myt-bot/footguard/docs/GAIT_CAPTURE_2026-08-15.md

# 2026-08-15 基础步态采集记录

本记录用于工程验证，不是医学步态诊断或糖尿病足临床结论。

## 时间与动作分段

- 手机记录约为 01:50～02:00，电脑比手机早约 2～3 分钟；数据库中有效承重数据集中在电脑时间 01:50:00～01:55:05。
- 01:50:00～01:50:55：初始静止与穿戴基线。
- 01:51:00～01:52:20：自然行走，包含三个来回及转身。
- 01:52:25～01:52:55：中间静止。
- 01:53:00～01:54:05：慢速行走，包含两个来回及转身。
- 01:54:10～01:55:05：结束静止。
- 01:55:05 之后压力基本归零，按卸载鞋垫处理，不纳入步态段。

## 初步结果

- 保存的站立基线 `load_ratio=0.0484`、`load_ratio_mad=0.0331` 可用于校正左右手工鞋垫灵敏度差，不能把行走样本混入站立基线。
- 新增基础步态观察使用近 12 秒窗口、左右交替承重和 MPU 运动状态。
- 本次数据回放中，静止段输出“静止”；自然行走窗口约 8 个落脚候选、估算 69 步/分钟；慢走窗口约 7 个候选、估算约 44～60 步/分钟。
- 转身或短暂停顿会使单个窗口暂时回到“静止”或“数据不足”，因此当前不把来回次数等同于连续直线步频。

## 数据质量限制

- 有效区间约 4455 对左右帧。
- 单侧帧间隔中位数约 50～60 ms，但按包序号估算约缺失 1660 个序号，丢帧比例约 27%。左右侧缺失序号基本同步，更像 App 配对或上传队列丢失，而不是单块鞋垫独立断流。
- 这批数据足以验证静止/行走、左右交替和时间戳步频算法，但不适合宣称最终 20 Hz 链路验收或步态准确率。

## 下一轮复测

1. 先修复或定位同步丢帧，使持续采集的序号缺失率降到 2% 以下。
2. 保持同一穿戴方式，分别采集直线自然走和直线慢走，转身段单独标记。
3. 每段同步记录人工步数，用于计算落脚候选的漏检和误检。
4. 至少重复三次穿戴，确认站立基线校正后步频仍稳定。

## 第二轮现场问题与修复

- 02:40～02:50 的第二轮测试中，数据库每侧仅收到约 1960 帧，并出现约 40 秒空洞。后端已在 02:42:17 将左偏载事件标记为恢复，但 App 因上传失败切到滞后的本地配对结果，仍显示未恢复。
- 原 App 配对器只保留左右各一帧；一侧先到下一包会覆盖尚未配对的上一包。现改为按 `sync_id + packet_seq` 缓冲 128 组，允许左右通知乱序到达。
- 上传改为 100 ms 微批次，本地队列每 500 ms 去抖保存；启动时历史补传数量单独计数，瞬时失败不再把后续实时帧送入只归档的补传接口。
- 后端为空载温度基线保留更长校准窗口，并可将已有的全 `unstable` 温度配置从本次原始空载段自动修复。第二轮配置已恢复为 3 个 `normal_offset` 和 1 个 `assembly_offset`，温度风险重新启用。
- 为 `sensor_frames(side, timestamp_ms)` 增加组合索引，当前数据库的 `/api/v1/realtime` 从约 1.2～1.4 秒降到约 60～80 ms。
