myt-bot/footguard/protocol/REVISION_NOTES_v1_2.md

# FootGuard protocol v1.2 修订说明

本修订发生在真实硬件联调前，以新的双足传感器示意图取代 `layout_6p3t_v1`。

## 破坏性变化

- 唯一支持的布局改为 `layout_6p4t_v1`：每脚 6 个压力通道和 4 个温度通道。
- BLE `layout_id` 从 1 改为 2。
- SensorData 从 58 字节改为 60 字节，温度字段从 `3×int16` 改为 `4×int16`。
- IMU、电量和 CRC 字段向后移动 2 字节；CRC 覆盖偏移 0～57，存放于 58～59。
- T4 占用 quality_flags 第 9 位，后续状态位整体后移一位。
- 旧 CSV、SQLite 数据库和旧 BLE 测试向量不得与新布局混用。

## 新通道映射

- P1 拇趾区；P2 前掌外侧；P3 前掌中央；P4 前掌内侧；P5 中足中央；P6 足跟中央。
- T1 前掌外侧；T2 拇趾/第一跖骨头邻近的前掌内侧；T3 足跟中央；T4 中足中央。
- 左右脚按解剖方向镜像，通道含义保持一致。

## 风险算法变化

- 不用原始压力固定阈值直接判定。
- 双足偏载使用归一化载荷差，区域风险使用足内占比、左右同区对比和个人动态基线。
- 温度使用左右镜像同区温差，并扣除个人正常温差基线。

固件、Flutter、后端、测试向量和模拟数据必须在同一次合并中同步升级。

竞赛演示中的后端马达命令有效期为 30 秒；设备重连产生新的连续监测窗口时，同类型旧事件不会阻止新命令生成。
