myt-bot/footguard/docs/DEMO_GUIDE.md

# FootGuard 初赛演示口径与操作清单

## 一句话介绍

“足安智垫”是一套面向糖尿病足日常管理场景的双足风险辅助监测原型。它不只显示压力和温度，还能比较个人基线和左右差异，识别持续风险，调用 DeepSeek 给出非诊断性解释，向风险侧震动提醒，并用后续数据验证提醒是否带来改善。

## 演示前 15 分钟

1. 电脑和手机连接同一局域网，电脑启动 FastAPI，DeepSeek 密钥已在环境变量中。
2. 两块 ESP32 分别供电，确认广播为 `FootGuard-L` 和 `FootGuard-R`。
3. App 选择“BLE 真机实时数据”，后端地址填写电脑局域网 IP。
4. 确认左右设备已连接、后台在线、双足同步误差稳定。
5. 实时页点击“新体验者 / 重新穿戴”，体验者双脚自然平行站立约 8～12 秒，确认进度达到 40/40 且显示“本次穿戴已就绪”。
6. 先测试一次目标侧震动和 ACK，再清理过期测试命令。
7. 准备 CSV/Mock 回放作为断网或实物故障备用，但不要把模拟画面说成真实采集。

## 建议视频流程（约 3～4 分钟）

### 1. 作品与架构（25 秒）

镜头展示双足实物、每脚 6 个压力点和 4 个温度点、两块 ESP32 与手机 App。

口径：

> 两只脚独立采集，通过 BLE 同步到同一个 App。电脑当前只在后台运行 FastAPI 和大模型调用，可以不出镜。风险识别由可解释规则和个人基线完成，大模型不直接控制马达。

### 2. 双足连接和个人基线（30 秒）

展示设备页的左右连接，在实时页开始本次穿戴标定并直接观察进度和失败原因。

口径：

> 不同人的体重、站姿、左右受力和鞋垫灵敏度都不同，所以每次重新穿戴都学习约 8 到 12 秒的稳定站立基线。校准完成前压力图照常显示，但压力风险和压力马达暂停，避免把鞋垫固有不对称当作风险。

### 3. 正常状态（20 秒）

自然站立，展示热力分布、左右温差和“双足状态正常”。

口径：

> 压力基础颜色显示当前低到高受力，无风险时也不会空白；风险用单独描边表达。温度采用左右同区比较，任一温度点缺失都不会影响压力图或压力风险。

### 4. 行走趋势（约 2 分钟）

先完成三段相互独立的短直线自然行走，确认均处于正常范围；再完成一段有意保持单侧偏载或前掌受压的行走。每段至少 6 次有效落脚、左右各至少 3 次，转弯后停稳约 2 秒再开始下一段。正式演示只选择“持续单侧偏载”或“前掌反复受压”之一，不演示内外侧或步时波动诊断。

口径：

> 单个有效行走段达到现有工程阈值即可触发一次语音提醒，足够用于现场演示；连续三段同向、同类型且累计至少 18 次落脚时，系统另外记录为重复趋势。低步频不单独判异常。

### 5. 持续偏载/前掌高载（45 秒）

缓慢把重心偏向预定一侧或保持前掌持续受力，不要突然猛踩。先保持到等级 2，确认准确风险名称播报。

口径：

> 瞬时高压不会立刻报警；只有持续达到条件才升级。等级 2 播报具体风险名称，但不会震动。

展示准确风险名称、全部组成项和已执行干预结果。站立可按左偏、右偏、左脚前倾、右脚前倾、双脚前倾、左脚内侧受压、右脚外侧受压的顺序演示；该顺序只是现场脚本，不是检测优先级。

### 6. 未改善升级（可选，25 秒）

继续保持风险至等级 3，展示对应风险侧的单次长震。

口径：

> 风险持续到最高等级后，系统只向对应脚发送一次长震；相同事件不会因 App 轮询而重复执行。

### 7. 干预前后效果（35 秒）

恢复自然站立，等待风险解除，打开历史页并展开最新事件。

口径：

> 系统比较干预前约 3 秒与 15 秒观察窗末端约 5 秒的有效静止数据。左右负载、前掌、内侧和外侧均按个人基线异常量显示改善或加重；数据不足时不下结论，温度不计入这项短时压力改善率。

### 8. 温度差异（可选，25 秒）

用手掌捂住单侧一个 NTC，缓慢升温；不要使用热风枪、明火、沸水或直接贴高温暖宝宝。

口径：

> 糖尿病足场景中温度差异值得关注，但本原型只做趋势辅助提醒，不作诊断。我们比较左右对应区域并扣除个人正常差异。

### 9. 总结（15 秒）

> 我们完成了双足真实感知、同步融合、个人基线、站立与行走负荷评估、云端大模型辅助解释、目标侧震动和干预后效果评价的完整 AIoT 闭环。后续工作是扩大参与者与行走数据，用于验证步态问题阈值和临床相关性。

## 评委常问问题

**为什么不用几十点压力鞋垫？**

本项目不以点数取胜，而以低成本关键区域采样、双足同步、个人基线、压力温度融合、闭环干预和效果评价形成差异化。六点压力不是连续医疗压力图，页面也明确按相对分布呈现。

**大模型有什么必要？**

确定性引擎负责风险和安全动作；大模型把结构化结果转成用户能理解的解释与建议。超时或格式错误会降级到模板，因此不会影响提醒闭环。

**换一个人还准吗？**

不能直接沿用上一人的基线。换人或重新穿鞋后都要快速标定，系统按其本次穿戴的载荷比、区域分布和噪声工作。当前只完成单人重复穿戴工程验证，现场可支持新体验者快速适配，但不宣称已验证多人准确率。

**为什么不显示电量？**

当前使用充电宝，协议中的百分比还不是可靠电量计读数，因此 App 主动隐藏。后续改为锂电池并接入真实电量计后再恢复电量和低电告警。

**为什么需要电脑？**

当前竞赛原型由电脑在局域网中运行 FastAPI 和 DeepSeek 调用，电脑可以不出镜。产品化时可迁移到公网云服务器，不改变鞋垫和 App 架构。

**MPU 现在有什么作用？**

固件和协议已采集加速度与角速度并带质量标记；完整的站立/行走/冲击约束需要更多可靠行走数据验证。演示不应把尚未验证的步态分类说成已完成医学能力。

## 失败时的降级顺序

1. DeepSeek 不可用：展示本地模板，强调核心判断不依赖大模型。
2. 后端网络异常：BLE 本地压力图继续显示，但风险闭环和马达暂停并明确提示；需要完整流程时切换准备好的 Mock/CSV，并清楚说明是演示数据。
3. 单脚断连：展示数据质量和暂停双足判断，不声称正常。
4. 马达未执行：展示命令过期/失败状态和 ACK 日志，不手动伪造成功。
5. 传感器接触不良：停止该场景，先检查空载与逐点响应，不临时放宽到明显误报。

## 最终复测记录

- 体验者编号与鞋码（匿名）
- 传感器固定版本和时间
- 五次独立穿戴，每次 40 对帧标定是否在约 12 秒内完成
- 每次自然站立 60 秒是否无等级 2/3 压力误报
- 左偏、恢复、右偏、恢复各 3 次，记录触发侧、触发时间和恢复时间
- 前掌受力和恢复各 3 次，记录触发与漏报情况
- 任一温度点、多个温度点或全部温度无效时，压力图和压力风险是否继续
- 等级 2 准确风险名称播报、等级 3 对应脚单次长震、ACK 是否正确
- 历史页干预前后值和恢复时间
- 所有调整过的阈值、理由与复测结果

今天固定前的数据仍可作为阶段性工程证据，用来说明通道响应、主要风险方向和闭环功能已经出现；由于传感器位置、接触和手工左右结构存在不确定性，不把它宣传为最终标定或准确率结论。胶固化后的短复测用于确认重复性并完成最终演示取材。
