myt-bot/footguard/docs/DEFENSE_QA_100.md

# FootGuard 足安智垫答辩材料

## 一、先把项目定位说准确

### 一句话定位

FootGuard 是面向**糖尿病足风险人群日常观察**的双足多源风险辅助监测原型。它把双脚相对压力、局部温度和运动状态放在同一条时间线上，发现持续或重复的受力/温度变化后，给出提醒、记录提醒后的变化，并用大模型把结果翻译成普通人听得懂的分析和建议。

### 它服务谁

主要服务对象是已经确诊糖尿病、但当前未必已经发生溃疡或感染、需要长期关注足部受力和温度变化的人，尤其是有周围神经病变、既往溃疡/截肢史、足部感觉减退、下肢供血问题、足部畸形或反复局部受压风险的人。

### 它不是什么

它不是医院诊断设备，不判断“有没有糖尿病足”，不计算 IWGDF 0–3 级，不预测某个人一定会溃疡，也不治疗感染、溃疡或缺血。对已经有破溃、感染、明显发热、发黑、剧痛或突然肿胀的人，设备只能作为记录工具，不能替代立即的专业足部检查。

### 为什么仍然和糖尿病足强相关

糖尿病足管理的重要方向包括减轻异常机械负荷、观察足部皮温不对称、及时发现重复的局部风险并进行专业复核。FootGuard 把这些方向变成低成本、可重复、可解释的工程观察：压力回答“哪里受力反复偏高”，温度回答“同一解剖区域是否出现持续温差”，行走分析回答“走动时是否重复偏向一侧或前掌”，提醒后记录回答“短时间内是否出现受力变化”。这些证据可以帮助用户更早注意问题，但不能替代临床检查。

### 主要依据

- IWGDF 2023 Prevention Guideline：家庭足温监测中，同一对应部位温差约 2.2°C、连续两天出现时，应减少活动并联系专业人员；项目把它作为设计参考，不把几十秒演示伪装成两天临床证据。
- IWGDF 2023 Offloading Guideline：糖尿病足高风险管理强调减负和避免异常机械应力；项目的压力区域、偏载和提醒后变化围绕“辅助发现需要减负/复核的受力模式”设计。
- ADA Standards of Care 2026 足部护理：既往溃疡/截肢、感觉减退和下肢供血问题是重要背景资料；项目只允许录入这两个最小背景提示，不冒充完整临床分层。
- 糖尿病神经病变与步态研究：步态指标存在较大异质性；项目保留行走步数、步频和受力指标作工程观察，不把单次步频或步时波动包装成诊断。

## 二、系统怎么工作

`FSR/NTC/MPU6050 -> ESP32-S3 -> BLE GATT -> Flutter App -> FastAPI/SQLite -> 规则引擎 -> AI解释/语音/马达 -> ACK -> 15秒观察 -> 历史趋势`

1. 每只鞋垫独立采集 6 路 FSR、4 路 NTC 和 1 个 MPU6050。
2. ESP32-S3 把一条完整传感器帧通过 BLE Notify 发给 App。
3. App 校验侧别、协议版本、布局、长度、CRC、时间同步和质量位，再把左右脚按 `sync_id + packet_seq` 配对。
4. App 将统一 JSON 上传给 FastAPI；后端不直接解析 BLE 字节。
5. 后端先判断帧能否用于压力/温度/步态，再用本次穿戴基线计算相对变化。
6. 确定性规则负责风险等级、语音和震动，AI 只负责解释，不拥有马达控制权。
7. ESP32 执行命令后回传 ACK；后端以真实 ACK 和观察窗口计算提醒后的变化。
8. 数据写入 SQLite，历史页显示事件、趋势、温度真实记录/演示记录、健康背景和血糖背景。

## 三、底层参数速查

| 项目 | 当前实现 |
|---|---|
| MCU | ESP32-S3 |
| FSR | 每脚 6 路，ADC1，P1-P6 映射 GPIO1-GPIO6，12 dB 衰减，每通道 32 次 ADC 采样平均 |
| NTC | 每脚 4 路，GPIO7-GPIO10/ADC1_CH6-CH9，10K B3950，固定 10K，3.3 V，32 次采样平均，ADC 曲线校准 |
| IMU | MPU6050，I2C0，SDA GPIO11，SCL GPIO12，7-bit 地址 0x68，100 kHz |
| MPU 配置 | SMPLRT_DIV=9，内部约 100 Hz；DLPF_CFG=3；陀螺 ±250°/s；加速度 ±2 g；App 帧读取频率为 20 Hz |
| 传感器帧 | 20 Hz，50 ms 一帧；压力和 MPU 每帧更新，温度每 4 帧刷新一次，即约 5 Hz，其余帧复用最近温度 |
| BLE 帧 | 固定 60 字节，little-endian，CRC-16/CCITT-FALSE 覆盖前 58 字节 |
| BLE MTU | App 请求 247；SensorData 至少需要 MTU 63；JSON 单包上限为 `MTU-3`，不分包 |
| TimeSync | 12 字节：uint32 `sync_id` + uint64 Unix 毫秒时间 |
| 双脚配对 | 相同 `sync_id`、相同 `packet_seq`、左右时间差不超过 50 ms |
| 标定 | 至少 40 对稳定完整压力帧，通常 8–12 秒；基线持久化到 SQLite |
| 压力平滑 | 5 个 5 Hz 压力样本，约 1 秒滚动中位数 |
| 行走观察 | 最近 12 秒；至少 4 秒、6 次交替落脚、左右各至少 3 次 |
| 压力风险持续 | 约 5 秒关注、10 秒需复核、20 秒持续异常 |
| 温度工程窗口 | 约 8 秒观察、15 秒语音、30 秒持续；不是“两天临床证据” |
| 震动 | 只有等级 3；目标侧单次 long，1500 ms；命令有过期时间和去重 |
| 恢复观察 | 干预前约 3 秒、干预后 15 秒窗口末端约 5 秒；每侧至少 5 个有效配对帧 |

## 四、100 个现场答辩问题与回答

### A. 定位、医学边界与需求（1–15）

**1. 你们的项目到底是给已经有糖尿病足的人，还是给风险人群？**  
答：定位是糖尿病足风险人群的辅助监测，尤其是已经患糖尿病、但需要日常关注压力、温度和皮肤变化的人。对已经存在溃疡、感染或缺血的人，设备不能治疗，只能提供记录和提醒，必须由专业人员处理。

**2. 为什么不直接叫“糖尿病足诊断系统”？**  
答：因为当前没有临床验证、没有完整神经/血管/皮肤检查，也没有足够证据把相对 FSR 数值映射成诊断。把它称为风险辅助监测更符合实际，也避免误导患者延误就医。

**3. FootGuard 和糖尿病足的直接关系是什么？**  
答：糖尿病足风险管理关注异常机械负荷、局部温度变化和早期复核。FootGuard 正好对这三类可穿戴信号做连续观察，帮助用户发现“同一侧/同一区域是否反复异常”，而不是声称仅凭鞋垫就能诊断。

**4. 为什么糖尿病患者需要压力监测？**  
答：周围神经病变可能降低保护性感觉，患者不一定能及时感到局部过载或鞋内异物。持续单侧负荷、前掌集中和局部集中是需要减负、检查鞋垫和观察皮肤的工程信号。

**5. 为什么需要温度监测？**  
答：同一对应部位的温度不对称可能提示局部炎症或异常负荷，需要减少活动并复核。IWGDF 的家庭温度建议强调同点、连续多日和专业联系，项目因此把温度做成独立观察项，不把短时间升温包装成诊断。

**6. 为什么还要测步态？**  
答：风险人群在感觉减退时，行走中的受力偏向可能先于明显不适被发现。项目只观察左右交替和受力趋势，不输出病理步态分型，也不把低步频单独解释为糖尿病足。

**7. 每只脚的 6 个压力传感器为什么这样分布？和糖尿病足有什么关系？**  
答：当前布局按解剖区域固定定义，并在左右脚做镜像：P1 是拇趾区，P2 是前掌外侧，P3 是前掌中央，P4 是前掌内侧，P5 是中足中央，P6 是足跟中央。这样安排是为了同时观察糖尿病足风险管理中最需要关注的几类机械负荷：拇趾和前掌对应推进期、跖骨头附近及前掌集中受力；内外侧点用于发现持续单侧偏载或前掌内部受力转移；中足点用于观察足弓/中足的异常承重；足跟点用于保留落地和后足参照。左右脚使用相同解剖语义，才能比较同点负荷差异并减少个体体重、鞋垫灵敏度和站姿的影响。六点是低成本原型的覆盖取舍，不是连续压力垫：它能做关键区域的相对趋势和重复异常观察，不能输出完整足底压力图、绝对 kPa 或临床溃疡阈值。

**8. 六点压力能否代表整个足底？**  
答：不能完全代表。它可以做关键区域的工程筛查和趋势比较，但遗漏点位会限制空间分辨率；临床压力垫或更高密度系统仍然更适合完整足底评估。

**9. 为什么选择双脚同时测量？**  
答：左右对应区域的相对比较能降低体重、鞋垫灵敏度和整体姿态差异的影响。对糖尿病足风险人群来说，同一部位左右差异比孤立的原始值更适合做日常趋势观察。

**10. 你们测的是绝对足底压力吗？**  
答：不是。FSR 输出经过归一化的 0–1 相对量，主要用于同一双鞋垫内、同一穿戴基线下的比较，不能标成 kPa，也不能套用压力垫的绝对临床阈值。

**11. 为什么不测血糖？**  
答：鞋垫没有血糖传感器，不能伪装成血糖仪。App 只允许用户手动录入自己已有的血糖值作为背景趋势，血糖不会直接改变足底压力或温度评级，也不会用于调整用药。

**12. 血糖和足部风险有什么关系？**  
答：血糖是糖尿病管理背景，长期控制与并发症风险相关，但单次血糖不能替代足部压力、温度、神经和血管检查。AI 只能说两者是否在同一时期出现，不能把一次血糖换算成“溃疡风险分数”。

**13. 为什么录入既往溃疡/截肢？**  
答：这是风险背景的重要信息，能提醒使用者对新出现的压力或温度变化更加谨慎。系统只展示背景提示，不据此自动计算 IWGDF 等级。

**14. 为什么录入感觉减退或供血问题？**  
答：保护性感觉减退和下肢供血问题会影响足部风险判断，是专业评估需要关注的背景。项目只提供“无/有/不确定”，不把两个字段包装成完整病史或临床分层。

**15. 你们能预测溃疡吗？**  
答：不能。我们能做的是在相对受力、温度或行走模式持续异常时提醒复查鞋垫、皮肤和负重情况；是否会溃疡需要临床检查、病史、神经血管状态和医生判断。

### B. 传感器、电子学与采样（16–30）

**16. FSR 是什么？**  
答：FSR 是力敏电阻，受力后电阻变化，再通过分压转换成 ADC 电压。它适合做低成本相对受力趋势，但迟滞、个体差异和长期漂移决定了必须进行本次穿戴基线，不能直接当医疗压力传感器。

**17. FSR 连接到什么接口？**  
答：每脚 6 路连接 ESP32-S3 的 ADC1，当前 P1–P6 对应 GPIO1–GPIO6。固件使用 ADC oneshot、12 dB 衰减，并对每个通道连续读取 32 次后取平均，减少 ADC 抖动。

**18. 为什么不是 I2C 读取 FSR？**  
答：当前 FSR 是模拟量，直接接 ADC 更简单、延迟更低。I2C 适合寄存器型数字器件，例如本项目的 MPU6050；没有必要为模拟 FSR 增加额外 ADC 芯片和总线协议。

**19. NTC 是什么？**  
答：NTC 是负温度系数热敏电阻，温度升高时电阻下降。项目使用 10K B3950 NTC 与 10K 固定电阻分压，经 ADC 曲线校准，再用 Beta 方程换算摄氏温度。

**20. 每只脚的 4 个温度传感器为什么这样分布？接什么接口？**  
答：T1 是前掌外侧，T2 是拇趾/第一跖骨头邻近的前掌内侧，T3 是足跟中央，T4 是中足中央；左右脚按解剖方向镜像。前掌内外侧和拇趾/第一跖骨头区域覆盖推进期和常见局部受力集中位置，足跟与中足提供后足、足弓区域的同点参照。对糖尿病足风险人群，温度重点不是看一只脚的绝对温度，而是比较左右对应解剖点是否出现持续温差；多区域布局可以区分局部热点和整脚/环境变化，但不能替代足部皮肤检查。硬件上 4 路 NTC 接 ESP32-S3 ADC1 的 GPIO7–GPIO10（ADC1_CH6–CH9），10K B3950 与 10K 固定电阻分压，每路 32 次平均，并检查 10–60°C 工程可用范围；超出或读取失败则设置温度无效位。

**21. 为什么温度不是每一帧都重新读？**  
答：温度变化比压力慢，NTC 反复读取会增加 ADC 时间和功耗。系统 20 Hz 发帧，但每 4 帧刷新一次温度，等效约 5 Hz，中间帧复用最近有效温度，这足以观察秒级温度趋势。

**22. MPU6050 通过什么接口？**  
答：MPU6050 通过 I2C0，SDA 为 GPIO11、SCL 为 GPIO12，7 位地址 0x68，I2C 时钟 100 kHz。初始化先探测 WHO_AM_I=0x68，再写寄存器确认器件正常。

**23. MPU6050 的采样率是多少？**  
答：MPU 内部通过 `SMPLRT_DIV=9` 工作在约 100 Hz，固件每 50 ms 读取一次并放进 20 Hz 传感器帧。答辩时要区分“MPU 内部输出率约 100 Hz”和“BLE/系统帧率 20 Hz”。

**24. MPU6050 配置了什么量程？**  
答：加速度为 ±2 g，陀螺仪为 ±250°/s，数字低通配置为 DLPF_CFG=3。这样优先保留站立、行走和鞋体振动的稳定变化，而不是追求高冲击实验的最大量程。

**25. MPU 在项目里负责什么？**  
答：它主要帮助区分静止站立和行走，辅助暂停静态压力风险，避免正常迈步被误报成持续偏载；同时提供运动质量信息。当前不宣称它能识别拖步、跌倒或完整病理步态。

**26. 为什么需要压力、温度和 IMU 三种传感器？**  
答：压力对应机械负荷，温度对应同区热差，IMU 对应是否在移动。三者互补：压力防止只看动作，温度补充炎症/局部异常观察，IMU 防止把正常行走过程误判为静态风险。

**27. 20 Hz 够不够？**  
答：对当前目标足部负荷趋势、持续时间、步间交替和秒级温度观察，20 Hz 是工程折中。它不等同于临床高频足底压力系统，也不适合精确捕捉足跟冲击峰值；更高频率需要同步考虑 BLE 吞吐、功耗、缓存和丢包。

**28. 为什么不是 100 Hz 直接传 BLE？**  
答：100 Hz 双脚多字段传输会显著增加 BLE 带宽、手机处理和功耗压力；当前目标是风险趋势和展示闭环，不是冲击力学研究。MPU 内部仍约 100 Hz，系统以 20 Hz 读取/传输，后续若研究足跟冲击可单独设计高频缓存上传。

**29. ADC 的 32 次平均解决了什么？**  
答：它降低瞬时 ADC 噪声和电源抖动，使相对变化更稳定。它不能解决 FSR 迟滞、安装偏移或传感器老化，所以仍必须重新穿戴标定和质量判断。

**30. 传感器掉线时会不会把 0 当成正常？**  
答：不会。无效通道虽然在固定帧中可能填 0，但同时设置 quality_flags；App 和后端按无效位排除，不把“无数据”解释为“没有压力”。这对糖尿病足很重要，否则断线可能伪装成减负成功。

### C. BLE、帧、时间同步与可靠性（31–45）

**31. BLE 用的是什么接口？**  
答：使用 BLE GATT。ESP32 作为外设，手机 App 作为中心设备；SensorData 用 Notify，DeviceStatus 用 Read/Notify，DeviceCommand 和 TimeSync 用 Write With Response，AckEvent 用 Notify。

**32. 服务 UUID 是什么？**  
答：服务 UUID 是 `7d2f0000-5a6b-4c7d-8e9f-102030405060`。SensorData、DeviceStatus、DeviceCommand、TimeSync、AckEvent 分别使用 0001 到 0005 的特征 UUID。

**33. 为什么左右脚要广播不同名称？**  
答：左脚是 `FootGuard-L/foot_left_001`，右脚是 `FootGuard-R/foot_right_001`，便于连接和演示。但 App 不只看名称，还校验 DeviceStatus.side 和 SensorData.side，避免左右脚身份接反。

**34. 一帧有多少字节？**  
答：固定 60 字节。包括 magic、版本、布局、侧别、质量位、同步编号、序号、时间戳、6 个压力、4 个温度、三轴加速度、三轴角速度、电量和 CRC。

**35. 60 字节如何分布？**  
答：0–1 是 `FG` magic；2 版本；3 布局；4 侧别；5–8 质量位；9–12 sync_id；13–16 packet_seq；17–24 时间戳；25–36 压力；37–44 温度；45–50 加速度；51–56 陀螺；57 电量；58–59 CRC。

**36. 为什么使用 little-endian？**  
答：协议明确统一为 little-endian，ESP32 和 App 解析器都按同一规则读写多字节整数。固定字节序能避免不同平台因为字节顺序不同产生时间、序号或压力数值错误。

**37. CRC 用什么算法？**  
答：CRC-16/CCITT-FALSE，poly=0x1021、init=0xFFFF、无反射、xorout=0，标准字符串校验值为 0x29B1。CRC 覆盖前 58 字节，接收端失败就丢弃当前帧，避免错误压力触发风险。

**38. 为什么不用 JSON 传每一帧？**  
答：二进制固定帧长度小、解析确定、带 CRC，适合 20 Hz 传感器流。JSON 保留给低频 DeviceStatus、DeviceCommand 和 ACK，方便调试而不浪费高频带宽。

**39. MTU 247 是什么意思？**  
答：MTU 是 BLE 链路层可协商的最大协议数据单元。App 请求 247，实际 ATT 有 3 字节开销；SensorData 60 字节只要求至少 MTU 63，JSON 则必须检查 `UTF-8 字节数 <= MTU-3`，不支持静默截断。

**40. SensorData 会不会分包？**  
答：v1 不支持传感器帧分包，也不允许一次 Notify 拼接多帧。每次 Notify 必须是一条完整 60 字节帧，长度不对就报错，这比“尽量拼起来解析”更容易保证数据完整。

**41. packet_seq 是干什么的？**  
答：它是每台设备独立递增的帧序号，用来发现同一连接、同一同步周期中的跳包。设备重启后可以从 0 重新开始，App 在重连或 sync_id 变化时重置预期序号，不能把重启误判为丢包。

**42. sync_id 和 packet_seq 有什么区别？**  
答：sync_id 标识一次时间同步/连接时基，左右脚相同 sync_id 才属于同一时间体系；packet_seq 标识该设备内部的帧顺序。前者解决“是不是同一轮时钟”，后者解决“这一侧有没有跳帧”。

**43. 时间同步怎么实现？**  
答：App 连接后生成非零 sync_id，并通过 TimeSync 写入 4 字节 sync_id 加 8 字节 Unix 毫秒时间。ESP32 收到时记录“手机 Unix 时间 + ESP 单调时钟读数”，后续用 `Unix基准 + 单调时钟经过时间` 生成时间戳，不依赖设备自己的不准确 RTC。

**44. 为什么不用每帧都发送手机时间？**  
答：每帧发送手机时间会浪费带宽，也会把手机调时抖动带入采样。一次同步建立偏移，之后由 ESP32 的单调时钟递推；重连或长连接周期到期再同步即可。

**45. 左右帧如何配对？**  
答：App/后端优先要求左右帧拥有相同 sync_id 和 packet_seq，并且时间差不超过 50 ms。无法配对时不生成可信双足偏载结论，避免把左脚旧数据和右脚新数据比较。

### D. App、后端、数据库和数据质量（46–60）

**46. Flutter App 在系统中是什么角色？**  
答：App 是 BLE 双设备中心、实时展示端和移动网关。它负责连接、协议解析、帧质量屏蔽、左右配对、向后端上传 JSON、接收命令并把 ACK 回传。

**47. 为什么后端不直接解析 BLE？**  
答：BLE 连接只存在手机附近，手机已经完成 GATT、MTU、侧别和 CRC 处理。后端接收统一 JSON，可以把设备协议和业务算法解耦，便于离线缓存、CSV 回放和未来更换通信方式。

**48. App 与后端用什么接口？**  
答：使用 HTTP/JSON，统一前缀 `/api/v1`，时间字段使用 Unix 毫秒。主要接口包括 `/sensor/batch`、`/realtime`、`/calibration/status`、`/events`、`/ack`、`/intervention/feedback`、`/session/latest` 和 AI 接口。

**49. 后端为什么用 FastAPI？**  
答：FastAPI 能用 Pydantic 对协议字段、范围和未知字段进行校验，并方便提供实时、历史、命令、AI 和导出接口。对竞赛原型来说，它同时具备清晰接口和较低部署成本。

**50. 数据库为什么用 SQLite？**  
答：当前是单手机/单演示场景，SQLite 不需要额外数据库服务，适合离线、现场部署和历史导出。风险事件、原始帧、命令 ACK、步态、温度日记录和会话摘要分表保存，后续可迁移到服务端数据库。

**51. 原始帧为什么也保存？**  
答：原始帧可以回溯“当时到底采到了什么”，用于验证传感器、重建风险、复查误报和导出数据。对糖尿病足场景，这能避免只保存一条“正常/异常”结论而无法解释。

**52. 风险事件为什么单独保存？**  
答：连续风险需要开始时间、结束时间、持续时长、风险侧、风险类型和干预关联。单独保存后，历史页可以显示重复事件和改善趋势，而不是把每一帧当成一次报警。

**53. 什么叫幂等？**  
答：同一个设备、同一个 sync_id、同一个 packet_seq 的帧重复上传不会重复入库；同一 command_id/device_id 的 ACK 重复上传不会重复震动或重复计算恢复。BLE、手机网络重试和后端轮询都可能重复，所以幂等是业务正确性要求。

**54. 断网时会发生什么？**  
答：App 保留 BLE、本地规则、语音、马达和离线缓存；后端断开不影响手机附近的基本闭环。恢复后用 offline-sync 和 offline-interventions 按序号/命令幂等补传，而且不补发已经过期的马达命令。

**55. 为什么不让断网时直接补发马达？**  
答：风险可能已经过去，补发震动会造成错误干预。糖尿病足风险管理强调及时但合适的减负，过期动作不能假装仍然适用于当前足部状态。

**56. 质量位有什么意义？**  
答：质量位区分压力通道无效、温度无效、IMU 无效、未同步、传感器卡死和跳包。不同风险使用不同质量门控，不能因为一个 NTC 无效就清空压力，也不能因为压力 P2 无效就把 0 当作真实无压。

**57. 为什么一只脚断连不能继续判断左右偏载？**  
答：偏载是双足相对量，缺一侧就没有比较对象。系统可以保留单脚画面或最后短时配对，但必须显示数据不完整，不给出可信的双足风险结论。

**58. 设备端和后端如何知道左右身份没错？**  
答：固件编译变体固定 side/device_id，广播名称只是第一层；App 读取 DeviceStatus 并同时校验服务 UUID、side、layout 和 SensorData.side。任一不一致就断开并报侧别不匹配。

**59. 为什么隐藏电量？**  
答：当前供电方式是充电宝，协议虽保留 battery 字段，但它不是可靠的锂电量计读数。为了不把不准确百分比展示给糖尿病足使用者，App 暂不显示电量。

**60. 数据库会不会因为重启丢基线？**  
答：不会。基线保存了设备、布局、样本数、载荷比、区域分布、MAD 噪声和通道可信度；后端重启或帧窗口滑动后仍可读取。换人、换鞋垫、移动传感器或改硬件后必须主动重新标定。

### E. 个人基线与压力算法（61–72）

**61. 为什么必须每次穿戴重新基线？**  
答：不同人的体重、站姿、足型、鞋垫贴合和 FSR 灵敏度不同，同一个原始值不能代表同一个风险。糖尿病足日常监测更关心“这只脚/这次穿戴相对平时是否变化”，所以每次重新穿戴学习个人参考。

**62. 基线采集多久？**  
答：至少 40 对完整稳定压力帧，标称 20 Hz 但标定采样约按 200 ms 间隔取样，通常需要 8–12 秒。基线过程中要双脚自然站立，不能走动、单脚悬空或只按一个点。

**63. 为什么用中位数而不是平均数？**  
答：中位数不容易被一次突然踩踏、脚趾抖动或鞋垫弹性尖峰拉偏。对低成本 FSR 和现场快速标定，中位数更适合形成稳定参考。

**64. MAD 是什么？**  
答：MAD 是中位绝对偏差，用来描述本次穿戴的噪声尺度。它让阈值既不会因每个人鞋垫灵敏度不同而失效，也不会把一次偶发跳变当成持续风险。

**65. 基线是否要求左右完全平衡？**  
答：不要求医学意义上的绝对平衡，而是排除明显未承重、单点残余和无法重复的候选帧。系统学习真实穿戴下的左右比，之后再判断相对该比值的变化。

**66. 压力风险为什么用对数载荷比？**  
答：左右载荷比用 `log((left+ε)/(right+ε))` 后，左右方向更对称，极小值也更稳定；再减去个人基线，可以抵消左右鞋垫整体灵敏度差。这是工程上的相对比较，不是体重或 kPa 的临床换算。

**67. 为什么还要滚动平滑？**  
答：当前使用约 1 秒、5 个样本的中位数，减少 FSR 瞬时抖动。糖尿病足风险关注持续受力而不是一瞬间踩踏，所以平滑有助于降低误报。

**68. 为什么设置进入和退出两个阈值？**  
答：如果进入和退出完全同一阈值，信号在边界附近会反复报警/解除。进入阈值约 0.20，退出约 0.16，形成滞回，页面和语音更稳定。

**69. 为什么不直接用“压力超过多少就危险”？**  
答：当前 FSR 没有经过临床压力垫标定，绝对值受材料、体重和安装影响。直接套固定人体压力阈值会把工程量伪装成临床量，违反项目边界。

**70. 前掌风险怎么计算？**  
答：用 P1–P4 占单脚有效总载荷的比例，与个人基线相比增加约 15 个百分点，并要求至少 70% 的有效落脚支持。它表达“前掌负荷分配持续集中”，不是诊断前掌溃疡。

**71. 内侧和外侧风险怎么计算？**  
答：内侧使用 P1+P4 相对前掌的比例，外侧使用 P2 相对前掌的比例，均和本次基线比较。它们保留在观察和历史改善中，当前不提升为正式行走趋势，因为六点布局和转弯过程容易放大局部变化。

**72. 为什么至少需要多点同时受力？**  
答：单个 FSR 的空载残余、胶体预紧或手指按压都可能产生高读数。运行期要求至少两个可信通道有接触证据，前掌还要求多个前掌点和后部参照，避免单点假报警。

### F. 行走检测与风险解释（73–82）

**73. 行走状态怎么识别？**  
答：先用 MPU 的加速度变化和角速度判断是否移动，再用左右载荷交替产生落脚候选。两者结合能区分静止站立、压力转移和真正的左右交替行走。

**74. 什么时候算一个有效行走段？**  
答：运动开始到连续静止约 2 秒形成一个完整段；段至少 4 秒、至少 6 次交替落脚、左右各 3 次，并要求每脚有足够可信压力通道。单段可以触发一次语音观察，但不等于临床步态诊断。

**75. 为什么有时十几步被切成多个段？**  
答：切分依据是运动状态和压力落脚之间的时间间隔。如果 MPU/压力在中间被判定为停止超过保持窗口，系统就结束当前段。现场若确实连续走，应检查 BLE 是否丢帧、MPU 安装是否松动、鞋垫是否断续接触，以及中间是否真实停顿。

**76. 为什么一次只有 6 步也能触发？**  
答：为了现场演示和短距离场地，工程规则把 6 步作为最小完整观察段。它只触发“本段观察/语音提醒”，只有同一穿戴中连续 3 段同方向同类型、累计至少 18 步才形成重复趋势。

**77. 行走风险和站立风险会不会互相干扰？**  
答：行走期间静态压力语音和马达规则暂停，走动压力只进入步态分析；温度独立运行。这样正常迈步时的瞬时左右受力变化不会被误认为持续站立偏载。

**78. 行走指标有什么糖尿病足意义？**  
答：左右受力时间积分和前掌比例可以提示走路时是否反复给同一侧或前掌增加机械负荷。它适合提醒检查鞋垫、鞋内异物和皮肤，不足以判断神经病变或病理步态。

**79. 为什么低步频不单独判异常？**  
答：步频受场地、身高、转弯、演示速度和个体习惯影响，糖尿病足研究对单一步频阈值也不一致。项目把步频展示为观察数据，不把它包装成疾病诊断。

**80. 为什么不识别拖步、足跟冲击和跌倒？**  
答：当前传感器数量、安装稳定性和人工标注样本还不足以支持这些分类。答辩应明确：项目已实现基础行走分段和受力趋势，完整病理步态分型是后续研究，不是当前承诺。

**81. 如果评委问“你明明右偏，为什么报左偏”怎么办？**  
答：先区分“人的意图”和“传感器实际读数”。系统在判定段内看到的是左右 FSR 的相对受力；如果左脚原始多点压力确实高，算法报左是对数据的忠实解释。若实际右偏而数据长期相反，应检查左右鞋垫实物、ESP side、P1–P6 映射、贴合和基线，而不是直接降低阈值。

**82. 组合风险为什么看起来只显示一个方向？**  
答：后端同时保存 `active_risks`，兼容字段 `risk` 只保留一个主风险给旧客户端。一个时段可能同时有左侧总负荷偏高和右脚内侧比例集中；答辩应说明“主标签不是全部组件”，新页面应优先看组合风险列表。

### G. 温度、演示与干预闭环（83–90）

**83. 温度是否按 IWGDF 两天规则？**  
答：真实证据必须按自然日记录，同一区域达到参考温差并在连续两天出现，才可称为两日温度证据。现场几十秒手按只演示传感器识别和流程，明确标为 demo，不拼接到真实评级。

**84. 为什么现场还要做温度演示？**  
答：评委无法等待两天，但可以验证 T1–T4 区域识别、同侧温升、语音提醒和演示标签。它展示的是系统流程，不声称模拟出患者真实两日临床证据。

**85. 为什么温度不触发马达？**  
答：短时温度变化可能来自手按、环境、接触或安装偏差，不能在未完成真实多日证据时直接执行机械干预。温度保持观察/语音，压力持续异常才进入当前震动闭环。

**86. 温度基线为什么要扣除？**  
答：不同 NTC、装配位置和左右鞋内环境会产生固定偏差。比较左右同区温差并扣除本次穿戴基线，可以减少“正常装配偏差”被误报为局部异常。

**87. 为什么 T3 可能有较大固定偏差？**  
答：足跟中央的接触、封装和热传导环境可能和前掌不同，项目会记录装配偏差状态。它不能直接宣称足跟温度绝对值异常，必须看校正后的同区变化和质量。

**88. 什么情况下震动？**  
答：风险达到等级 3 且持续未改善时，只向对应风险侧发送一次 long 震动，当前时长 1500 ms。等级 2 只播报准确风险名称，避免把每个短时观察都变成强干预。

**89. 为什么要 ACK？**  
答：BLE Write With Response 只表示设备收到了写入，不等于马达实际执行。ESP32 回传 executed/rejected/expired/failed，App 和后端据此决定是否开始 15 秒恢复观察，不能把“发送成功”伪装成“震动成功”。

**90. 如何避免马达震动影响行走状态？**  
答：后端记录命令目标脚和 1500 ms settle window，只屏蔽目标脚 MPU 的马达诱发运动；压力风险仍按真实压力判断，另一侧真实运动保留。这样马达不会把真实左偏载强行显示成“双脚正常”或把状态改写成“行走中”。

### H. 改善、历史、评级与 AI（91–100）

**91. 为什么要记录干预前后改善？**  
答：糖尿病足管理不只要发现异常，也要知道减负/调整姿势后是否变化。项目比较提醒前约 3 秒和 15 秒观察窗口末端约 5 秒的有效静止数据，记录改善、部分改善、无改善或加重。

**92. 为什么温度不计算 15 秒改善率？**  
答：温度的临床参考强调自然日重复，不是短时马达前后压力窗口。把十几秒温度下降叫“减负成功”会夸大医学含义，所以温度只做观察项。

**93. 数据不足时为什么不猜改善？**  
答：如果提醒前后每侧不足 5 个有效配对帧，或者仍在运动、断连、通道无效，计算出来的比例不可靠。对高风险足部人群，诚实显示“无法比较”比制造一个好转百分比更安全。

**94. 历史趋势怎样计算？**  
答：以重新穿戴/重新标定作为会话边界，比较最近一次和上一次完整会话的评级、压力事件、行走证据和真实温度日证据。数据质量下降时禁止显示“好转”，避免因为少采数据而虚假改善。

**95. 四档评级是医疗等级吗？**  
答：不是。正常、关注、需复核、持续异常是 FootGuard 近期监测等级，只描述本设备采到的证据；它不等于 IWGDF 0–3 级，也不等于溃疡概率。

**96. AI 大模型为什么需要存在？**  
答：规则引擎擅长稳定、可审计地判断风险和控制马达；大模型擅长把“最近哪一侧、哪一区域、是否重复、提醒后是否变化”翻译成观众听得懂的分析和建议。AI 不参与安全阈值、目标侧或命令生成。

**97. AI 输入什么？**  
答：会话 AI 接收结构化摘要，例如近期压力事件、步态趋势、温度真实/演示证据、数据完整度、足部背景和血糖背景，不上传连续原始传感器帧。这样既减少模型复述开发字段，也能保留答辩需要的证据链。

**98. AI 失败怎么办？**  
答：网络、API Key、超时或 JSON 格式错误时，后端自动使用本地确定性模板；压力风险和马达闭环不依赖云端。现场可解释为“AI 是解释层，规则引擎是安全和判断层”。

**99. AI 会不会把演示温度说成患者真实两日风险？**  
答：提示词和结构化摘要明确区分 `demo` 与真实自然日记录；云端返回内部术语时会被拒绝并回退。页面始终显示“演示数据”，不参与真实评级，也不与真实记录拼接。

**100. 你们下一步怎样证明它真的有临床价值？**  
答：先完成硬件固化后的重复穿戴、左右偏载、前掌受力、恢复和温度流程测试，再做多人、不同鞋码、不同足型和人工标注的压力/步态数据采集。之后需要与临床压力垫、温度测量和医生标注对照，评估灵敏度、特异度、重复性和误报；在此之前只宣称工程闭环，不宣称临床准确率。

## 五、评委追问时的统一底线

1. 任何“诊断、治疗、溃疡预测、IWGDF 分级、临床阈值、准确率”问题，都回答当前没有这样的临床验证或产品资质。
2. 任何“为什么报错/为什么不报”问题，都先看原始数据、质量位、时间配对、个人基线和持续时间，不先改阈值。
3. 任何“大模型控制设备”问题，都回答：规则引擎决定风险和命令，AI 只生成解释；AI 失败不会阻止安全闭环。
4. 任何“温度两天”问题，都明确真实自然日证据和现场 demo 的边界，绝不把几十秒说成两天。
5. 任何“压力单位”问题，都回答当前是相对 FSR 量，不是 kPa，不使用临床压力垫绝对阈值。
6. 任何“换人能不能用”问题，都回答必须重新穿戴标定；当前完成的是工程原型验证，不是多人临床准确率验证。

## 六、现场可以主动展示的证据

- ESP32-S3 左右两块实物、`FootGuard-L/R` 广播名称和 6P4T 传感器布局。
- App 设备连接、双脚同步误差、40/40 个人基线进度和压力热力图。
- 一段正常行走和一段有意偏载/前掌受力，展示单段语音与步态记录。
- 持续压力到等级 3 后的目标侧震动、设备 ACK 和 15 秒观察倒计时。
- 历史页压力改善/加重、温度真实记录与演示记录分开、会话 AI 观众版建议。
- 断开后本地缓存、恢复后幂等补传；明确标注 CSV/Mock 是演示数据。

## 七、推荐的结束语

“FootGuard 的定位不是把一个低成本鞋垫包装成医疗诊断仪，而是围绕糖尿病足风险人群最需要长期关注的机械负荷、局部温度和重复变化，建立一条可解释、可追溯、可离线运行的辅助监测闭环。规则保证判断和动作可审计，大模型负责让结果更容易被使用者和现场观众理解；真正的临床分级和治疗仍然交给专业足部检查。”

## 参考资料与代码入口

- IWGDF 2023 Prevention Guideline: <https://iwgdfguidelines.org/wp-content/uploads/2023/07/IWGDF-2023-02-Prevention-Guideline.pdf>
- IWGDF 2023 Offloading Guideline: <https://iwgdfguidelines.org/wp-content/uploads/2023/07/IWGDF-2023-06-Offloading-Guideline.pdf>
- ADA Standards of Care 2026, Foot Care: <https://diabetesjournals.org/care/article/49/Supplement_1/S261/163919/12-Retinopathy-Neuropathy-and-Foot-Care-Standards>
- 协议实现：[ble_protocol_v1.md](../protocol/ble_protocol_v1.md)、[field_dictionary.md](../protocol/field_dictionary.md)
- 风险规则：[RISK_RULES.md](../backend/RISK_RULES.md)
- 现场脚本：[DEMO_GUIDE.md](DEMO_GUIDE.md)
- 固件采集：[footguard_real_sensor.c](../firmware/main/footguard_real_sensor.c)、[footguard_fsr.c](../firmware/main/footguard_fsr.c)、[footguard_ntc.c](../firmware/main/footguard_ntc.c)、[footguard_mpu6050.c](../firmware/main/footguard_mpu6050.c)
- BLE 帧与时间：[footguard_protocol.c](../firmware/main/footguard_protocol.c)、[footguard_time.c](../firmware/main/footguard_time.c)
- 后端规则：[risk_service.py](../backend/app/services/risk_service.py)
- AI 解释：[ai_advisor_service.py](../backend/app/services/ai_advisor_service.py)
