myt-bot/footguard/docs/DEFENSE_QA_100_MORE.md

# FootGuard 第二组现场答辩材料：问题 101–200

本文件是 [DEFENSE_QA_100.md](DEFENSE_QA_100.md) 的续篇。问题编号从 101 开始，回答依据当前仓库中的 `protocol/`、`firmware/`、`backend/`、`mobile_app/`、`sample_data/`、`tools/` 和测试文件整理。

答辩时必须区分三种证据：IWGDF/ADA 等指南是医学设计依据；代码和自动化测试是工程实现证据；健康体验者和 CSV 是联调/演示证据，不能替代糖尿病患者临床研究。FootGuard 的定位始终是糖尿病足风险人群的辅助监测原型，不是诊断、治疗或 IWGDF 分级设备。

扫描仓库后还要如实说明两项实现状态：一是后端 `DeviceCommand` Pydantic 模型允许 `medial_load_concentration`/`lateral_load_concentration`，但 `protocol/command_schema_v1.json` 和 `firmware/main/footguard_command.c` 的 reason 白名单尚未同步这两个值，这类风险若达到马达级别可能被协议或固件拒绝；二是 `firmware/README.md` 保留了早期“模拟 SensorData/单路验证”的阶段描述，当前代码路径应以 `footguard_ble.c -> footguard_real_sensor.c`、串口日志和实物测试为准。两项都不是医学结论，属于答辩时必须区分的工程现状。

## A. 糖尿病足医学依据与产品边界（101–110）

**101. 糖尿病足在医学上只等于“脚上有溃疡”吗？**  
答：不是。糖尿病相关足部问题还涉及神经病变、周围动脉疾病、感染、足部结构异常和异常机械负荷；溃疡是严重结局之一。项目面向尚未必有当前溃疡、但存在这些风险背景的人做辅助观察，不能把“没有检测到压力异常”解释成“没有糖尿病足”。

**102. 为什么产品定位是“糖尿病足风险人群”，不是“已经患糖尿病足的人”？**  
答：当前只有相对 FSR、NTC、IMU 和有限点位，没有皮肤、神经、血管或创面检查，也没有临床等效性验证。因此产品能帮助风险人群发现需要复核的变化；已有溃疡、感染、缺血或急性炎症时，应直接接受专业评估，不能依靠鞋垫治疗。

**103. 周围神经病变为什么会改变压力监测需求？**  
答：保护性感觉减退会使患者不容易感到鞋内异物、局部过载或反复摩擦，机械损伤可能在疼痛出现前累积。FootGuard 用持续时间、多点接触和相对基线控制提醒，目的在于促使用户检查鞋袜、皮肤和负重，不是诊断神经病变。

**104. 周围动脉疾病和本项目有什么关系？**  
答：供血不足会增加伤口愈合困难的风险，但压力/温度鞋垫不能测踝肱指数、脉搏或血流。项目只把用户自述的“曾被医生提示供血问题”作为背景提示，不能据此排除缺血，也不能根据某一次温度值判断血管状态。

**105. 既往溃疡或截肢史为什么值得录入？**  
答：既往溃疡和截肢史是专业足病风险评估的重要背景，新的受力或温度变化需要更加谨慎地复核。App 的 `HealthProfile` 只保存“无/有/不确定”，不把它换算成 IWGDF 0–3 级。

**106. 为什么不让系统给出“溃疡概率 37%”之类的数字？**  
答：那需要经过定义明确的人群、金标准、随访时间和外部验证的预测模型；仓库没有这样的数据。当前显示的是设备采到的风险证据和数据质量，避免把工程分数伪装成临床概率。

**107. IWGDF 温度规则到底是什么，项目采用了哪一部分？**  
答：IWGDF 2023 预防指南把双脚对应部位的皮温差约 2.2°C、连续两天作为需要减少活动并联系专业人员的家庭监测参考。项目采用“同侧、同点、跨日记录”的思想，但 NTC 尚未完成临床等效验证，几十秒演示不会被写成真实两日证据。

**108. 为什么指南强调“同一部位”，不能比较脚背和足跟？**  
答：不同解剖部位的正常温度受软组织、接触、血流和环境影响不同，跨部位比较会把正常解剖差异混成异常。协议因此固定 T1–T4 的同点镜像比较，并在基线中保存装配偏差。

**109. 发现温差后，指南意义上的下一步是什么？**  
答：应先复测同一部位并检查鞋袜、活动、环境和皮肤；真实持续两日时减少相关负重活动并联系专业人员。App 的语音只说“温度观察”，不会给出自行调药、贴敷或治疗建议。

**110. 哪些情况必须跳过 App 直接就医？**  
答：新出现的破溃、渗液、明显红肿热痛、发黑、脓性分泌物、发热或突然肿胀等，应按医疗急症或专业足部评估处理。FootGuard 没有感染培养、创面测量或血管检查能力，不能用“设备正常”延误就医。

## B. 鞋垫点位、力学含义与安装（111–120）

**111. P1 拇趾点具体解决什么问题？**  
答：P1 位于拇趾/最前端，用来观察推进阶段的前端受力和内侧前掌占比。糖尿病足高风险人群若保护性感觉下降，重复的趾端或前掌机械负荷应提醒检查鞋头空间和皮肤；P1 不是拇趾溃疡诊断点。

**112. P2 前掌外侧为什么单独放一个点？**  
答：P2 表示前掌外侧，可和 P4 内侧比较前掌内部受力转移，也可作为外侧区域的主要证据。它帮助识别持续外侧集中或代偿性偏载，但一个点不足以代表整个外侧跖骨区域，因此算法要求多点承重支持。

**113. P3 前掌中央的作用是什么？**  
答：P3 是前掌中央参照，和 P1、P2、P4 一起计算前掌占总载荷的比例。前掌风险表达负荷分配变化，不把单个 P3 原始读数映射成临床峰值压力。

**114. P4 前掌内侧为什么要保留？**  
答：P4 表示前掌内侧，与 P1 共同组成内侧区域指标；它能观察内侧推进或偏载时的分配变化。糖尿病足相关机械负荷管理强调减少异常重复负荷，但本点仍只提供相对工程证据。

**115. P5 中足中央的医学和算法用途是什么？**  
答：P5 给中足/足弓区域一个参照，帮助区分“前掌比例升高”和“整只脚总载荷升高”。六点方案不能评估足弓塌陷、Charcot 足或结构畸形；这些必须由医生查体和影像/足部评估判断。

**116. P6 足跟中央为什么不能省略？**  
答：P6 作为后足落地参照，支持行走时的足跟接触和前掌计算的后部对照。算法在前掌判据中通常要求至少一个后部有效点，但真实前倾时不强制足跟持续承重，避免把合理的前倾动作误判为断线。

**117. 左右脚为什么要使用镜像后的同一语义，而不是左右各自编号？**  
答：业务逻辑需要比较“左脚 T2 与右脚 T2”这种同解剖位置；左右鞋垫只是几何镜像，P2 在两侧都代表该脚的前掌外侧。协议用 `layout_6p4t_v1` 固定语义，避免更换左右脚时算法把区域意义弄反。

**118. T1–T4 的温度点为什么不是只放一个？**  
答：T1 前掌外侧、T2 拇趾/第一跖骨头邻近、T3 足跟中央、T4 中足中央，覆盖前足、后足和中足的同点比较。多区域能显示局部性，但不能声称覆盖足底每一处皮温，也不能替代医生对皮肤颜色、破损和血流的检查。

**119. 传感器放歪一点会产生什么影响？**  
答：会改变接触面积、预紧和左右同点对应关系，造成固定偏差或通道失配。工程上通过重新固定、空载逐点验证和本次穿戴基线降低影响；若点位移动，必须重新标定，不能只降低报警阈值。

**120. 为什么不能把传感器贴在鞋垫表面让用户直接踩到？**  
答：凸起会改变鞋内压力和摩擦，反而可能给高风险足部增加局部刺激。实际装配应保持平整、避免锐边、固定线材，并由专业人员检查鞋内是否有新摩擦源；项目当前只验证传感器趋势，不证明长期佩戴安全性。

## C. FSR、NTC 与 ADC 电子实现（121–130）

**121. FSR 的电路为什么用分压？**  
答：FSR 受力后电阻变化，和固定电阻形成电压分压，ESP32 ADC 读取电压再归一化到 0–1。FSR 具有迟滞、非线性和漂移，所以本项目把它用于同一穿戴的相对比较，而不是绝对压力标定。

**122. 六路 FSR 具体接到哪里？**  
答：`footguard_fsr.c` 将 P1–P6 映射到 GPIO1–GPIO6，即 ADC1_CH0–CH5，并用 ESP-IDF ADC oneshot 读取。初始化还通过 GPIO 到 ADC 通道反查确认物理映射，映射异常会返回错误。

**123. 12 dB ADC 衰减意味着什么？**  
答：它扩大 ADC 可测输入电压范围，使 3.3V 分压在工程量程内不容易过早饱和；它不是提高传感器精度的魔法。最终仍要用实际分压电阻、FSR 量程和 ADC 校准验证饱和点。

**124. 为什么每个 ADC 通道平均 32 次？**  
答：固件在一次读取中累计 32 个 oneshot 原始样本再取整除平均，主要降低瞬时噪声和供电抖动。它不能消除鞋垫安装偏差、FSR 迟滞或长期漂移，因此还需要个人基线和重复穿戴。

**125. NTC 的 Beta 方程输入是什么？**  
答：10K B3950 NTC 与 10K 固定电阻、3.3V 供电形成分压，先把 ADC 读数转换成电压/电阻，再用标称电阻和 Beta 参数换算摄氏温度。温度公式是工程传感器换算，不等于经过人体皮温临床验证。

**126. 为什么 NTC 还要做 ADC 曲线拟合校准？**  
答：ESP32 ADC 的理想线性关系会受芯片和衰减误差影响，曲线拟合把原始码转换为更可信的毫伏值。它修正电子测量误差，但不能修正 NTC 与皮肤之间的热阻、封装和接触变化。

**127. 温度为什么每 4 帧刷新一次？**  
答：固件压力/IMU 帧周期是 50 ms，即 20 Hz；`FOOTGUARD_TEMPERATURE_FRAME_DIVISOR=4`，所以 NTC 约每 200 ms 刷新一次、约 5 Hz，中间帧复用最近有效值。秒级温差和演示升温足够使用这个频率，也降低 ADC 采集负担。

**128. 传输允许温度 -40～125°C，固件又看 10～60°C，哪个是医学阈值？**  
答：两者都不是医学阈值。Pydantic/协议范围是防止编码溢出的传输边界；固件 10～60°C 是检测悬空、短路或明显不可信 NTC 的工程可用窗口，真正的皮温异常仍需要同点、基线和持续时间。

**129. ADC1 为什么由 FSR 和 NTC 共享？**  
答：两类信号都是慢速模拟量，使用 ESP-IDF 的共享 ADC1 句柄可减少外部器件和引脚数量。代码在 `footguard_adc.c` 统一创建 oneshot 单元，通道初始化分别验证，采集任务按 40 ms 预算完成。

**130. 采集超过 40 ms 会怎样？**  
答：BLE 采集任务记录 acquisition overrun 并继续下一周期，不把超时伪装成准时采样；质量和时间戳由 App/后端继续检查。糖尿病足趋势观察可以容忍少量间隔变化，但若要研究冲击峰值必须先解决调度和带宽问题。

## D. MPU6050、任务调度和固件真实状态（131–140）

**131. MPU6050 使用什么总线和地址？**  
答：`footguard_mpu6050.c` 使用 I2C0，SDA GPIO11、SCL GPIO12，100 kHz，GY-521 默认 7 位地址 `0x68`。启动先检查 WHO_AM_I，设备不存在会报告 `ESP_ERR_NOT_FOUND` 并把 IMU 标成无效。

**132. MPU6050 配置了哪些寄存器级参数？**  
答：固件设置加速度 ±2g、陀螺 ±250°/s、采样分频 `SMPLRT_DIV=9`、DLPF_CFG=3，并周期性读取六轴数据。±2g/±250°/s 是当前站立、行走和鞋体振动的工程取舍，快速旋转饱和不等于 I2C 断线。

**133. 为什么 MPU 内部约 100 Hz，系统只发送 20 Hz？**  
答：MPU 内部输出率较高可以先经过数字低通，固件每 50 ms 读取一次并放入 SensorData；BLE 20 Hz 用于运动状态和步间趋势。项目没有宣称 20 Hz 可重建完整足底冲击波形。

**134. IMU 的加速度单位为什么传输成 mg？**  
答：固定帧把 `g` 值乘 1000 量化为 int16，接收端再乘 9.80665/1000 还原 m/s²，节省字节并保证可重复解码。陀螺则以 °/s×10 量化，温度以 °C×100 量化。

**135. 固件为什么要把 IMU 无效和压力无效分开？**  
答：压力主要用于承重风险，IMU 主要用于运动门控；某一类故障不应清空另一类真实信号。规则层会在 IMU 无效时把运动状态设为 unavailable，而不是把静止或行走硬猜成某一类。

**136. `footguard_real_sensor.c` 和 mock 传感器是什么关系？**  
答：当前 BLE 采集循环调用 `footguard_real_sensor_make_data`，该函数读取已初始化的 FSR、NTC 和 MPU；电量仍来自 mock 电量函数。CSV/mock 数据源属于 App/后端演示和回放，不能在答辩中说成穿戴者的真实临床数据。

**137. 真实 FSR/NTC 未接好时，帧如何表达？**  
答：`real_sensor` 先把对应质量位全部置为无效，成功读到的通道再逐位清除无效标记；温度保留最近样本但只有最近刷新有效才清除该通道位。这样断线不会被编码成“正常零压力”。

**138. 为什么固件启动先跑协议自测？**  
答：`app_main.c` 在 BLE 启动前检查 CRC、左右标准帧和 DeviceCommand 解析自测；任一失败就不启动 BLE。对糖尿病足演示而言，先保证帧不会错解，比带着协议错误继续采集更可靠。

**139. 传感器采集任务为什么不放在 GATT 写回调里？**  
答：GATT 回调只负责快速解析和提交，传感器采集、JSON 命令和马达执行由独立 FreeRTOS 任务完成，避免阻塞 BLE 主机。调度隔离可以减少连接丢失和命令时序互相影响。

**140. 固件文档和代码对真实硬件状态不一致时怎么答？**  
答：以当前编译代码、串口日志和实测硬件为准；仓库中的 `firmware/README.md` 含有历史阶段描述，不能拿旧的“模拟帧/单路验证”文字覆盖最新代码。现场应明确哪些通道已接线验证、哪些只通过协议/桌面验证，绝不把未实测硬件说成临床验证。

## E. BLE GATT、固定帧与协议错误处理（141–150）

**141. ESP32 和手机在 BLE 中分别扮演什么角色？**  
答：ESP32 是 GATT Peripheral，发布 FootGuard Service；Flutter Android 是 Central，扫描、连接、订阅 Notify 并写入 TimeSync/DeviceCommand。BLE 只负责近距离设备链路，风险规则在 App 本地和 FastAPI 后端各有一份对应实现。

**142. 为什么要校验服务 UUID、DeviceStatus.side 和 SensorData.side 三层身份？**  
答：只看广播名可能连接到同名或配置错误的板子；三层校验能防止左右鞋垫在业务上被交换。左右比较是糖尿病足压力观察的核心，身份错一侧会让所有结论方向相反。

**143. SensorData 的 60 字节为什么是固定长度？**  
答：固定长度使 BLE Notify 不需要分包重组，解析器可按偏移直接读取并用 CRC 校验。压力 6×uint16、温度 4×int16、IMU 六轴和状态字段在有限 MTU 下保持可预测带宽。

**144. 60 字节帧中压力如何编码？**  
答：偏移 25–36 存 6 个 little-endian uint16，编码为 `round(value×10000)`，解码除以 10000 得 0～1 相对量。它保留相对分布精度，不代表 kPa 或峰值压力。

**145. 温度和 IMU 的量化精度是多少？**  
答：温度偏移 37–44，以 °C×100 存 int16，约 0.01°C 量化；加速度偏移 45–50，以 g×1000 的 mg 存 int16；陀螺偏移 51–56，以 °/s×10 存 int16。量化精度不等于整机临床准确度，接触热阻和安装误差仍是主要限制。

**146. CRC-16/CCITT-FALSE 的覆盖范围为什么不包含 CRC 自身？**  
答：计算偏移 0–57 的 58 字节，把结果写到 58–59；接收端按同样范围重算并比较。参数是 poly 0x1021、init 0xFFFF、check 0x29B1，能发现常见传输位翻转而不改变业务判断。

**147. BLE Notify 收到半帧怎么办？**  
答：v1 不支持半帧拼接或一包多帧；长度不是 60、magic/版本/layout/side/CRC 不对就丢弃并记录解析错误。宁可标数据不足，也不让错误压力值触发糖尿病足相关提醒。

**148. MTU 247 和 63 的关系是什么？**  
答：247 是 App 请求的协商值；ATT 有 3 字节开销，所以 60 字节 SensorData 至少要求 MTU 63。紧凑 JSON 必须满足 UTF-8 字节数不超过 `MTU-3`，不足时停止对应操作而不是静默截断。

**149. DeviceCommand 写成功为什么还要 AckEvent？**  
答：Write With Response 只证明 GATT 属性写入被接收，命令可能过期、冲突、排队失败或马达驱动失败。只有 AckEvent 的 `executed` 才能启动 15 秒恢复观察，避免把“已发送”说成“已干预”。

**150. 为什么 DeviceStatus 也要 Read/Notify？**  
答：连接后 Read 可立即得到版本、布局、侧别、同步和错误状态；状态变化时 Notify 可让 App 更新连接卡。设备状态不是高频帧，不需要每 20 Hz 重复发送。

## F. 时间、配对、丢包与接口数据完整性（151–160）

**151. TimeSync 的 12 字节具体怎么用？**  
答：App 生成非零 uint32 `sync_id` 和 uint64 Unix 毫秒时间，用 little-endian 写入 12 字节特征。ESP32 记录该 Unix 基准和 `esp_timer_get_time()` 单调时钟，后续用经过的单调时间递推 Unix 时间戳。

**152. 为什么不使用 ESP32 自己的 RTC？**  
答：现场设备重启或没有可靠电池 RTC 时绝对时间不可信；手机和后端需要把左右脚帧、事件和历史放到同一时间线上。单调时钟只负责短期递推，重启或断连后重新同步。

**153. `sync_id` 和 `packet_seq` 各解决什么问题？**  
答：`sync_id` 标记同一轮时间基准，`packet_seq` 标记单个设备的帧顺序。两脚只有在 sync_id、packet_seq 相同且时间差不超过 50 ms 时才形成可信双足比较。

**154. 右脚比左脚晚 20 ms 会被拒绝吗？**  
答：不会，协议配对窗口允许不超过 50 ms；样例数据也用 20 ms 的右脚偏移模拟真实 BLE 到达差异。超过窗口时暂不生成该对的双足偏载结论，防止把不同动作时刻混在一起。

**155. 为什么 App 会短时保留上一对完整帧？**  
答：左右 BLE Notify 到达时间可能轻微错开，立即清空会造成热力图和状态闪烁。系统只在短暂连续性窗口内保留最近完整配对，超过严格新鲜度/连续性间隔后显示数据不完整，不长期伪装在线。

**156. `packet_seq` 跳号是否必须丢弃后续全部帧？**  
答：不必。协议把跳号标为 PACKET_GAP，后续合法帧仍可使用；只有同一连接、同一 sync_id 内的非预期跳变才计为丢包，重连或设备重启时序号预期重置。

**157. Pydantic 为什么拒绝未知字段？**  
答：`StrictModel` 设置 `extra="forbid"`，接口字段变更必须同步协议和测试。对风险监测来说，未知字段如果被静默忽略可能表示版本错配；明确 422 让联调人员知道需要升级双方。

**158. 单帧错误和整批错误怎样区分？**  
答：外层 JSON/协议结构错误会让整批返回 422；批内单帧能独立解析时按 `accepted/rejected` 统计。这样网络批处理不会因为一帧损坏丢掉另一只脚的有效记录，同时仍保留质量边界。

**159. `source=ble`、`mock`、`csv_replay` 为什么必须保留？**  
答：来源决定证据可信度和页面口径；CSV 可以证明演示流程，但不应冒充真实穿戴。会话 AI 和 Web/App 都可据此标注演示数据，避免把健康体验者样例当糖尿病足临床证据。

**160. 为什么要把 App 接收时间和设备时间都保存？**  
答：设备时间用于左右配对、持续时长和事件顺序，App 接收时间用于观察网络延迟和离线批次。两者分开能解释“采样发生了但晚到”，不会用上传延迟伪造足部风险持续时间。

## G. FastAPI、SQLite 和离线数据链路（161–170）

**161. FastAPI 的入口如何启动？**  
答：`backend.app.main:create_app` 创建数据库、过期旧命令并注册 health、sensor、realtime、assessment、analytics、AI、command、demo 等路由；Uvicorn 暴露 HTTP 服务。App 通过同局域网地址访问，电脑只承担网关、数据库和 AI 调用。

**162. 后端收到一批左右交错帧后先做什么？**  
答：`/api/v1/sensor/batch` 按 `(sync_id, packet_seq)` 分组，再按组内最大时间排序，把左右帧以时间顺序写入 `sensor_frames`，随后只对最新配对评估风险。这个顺序既支持左右交错，又避免重复扫描整段历史。

**163. 数据库怎样阻止同一帧重复入库？**  
答：`SensorFrame` 有 `(device_id, sync_id, packet_seq)` 唯一约束，repository 重复插入会计为 rejected。BLE 重试、HTTP 重试或离线补传不会把同一采样扩大成多次风险。

**164. 为什么风险事件不按每帧保存一条？**  
答：`RiskEvent` 保存开始、结束、持续时间、等级、侧别和组合组件；连续满足同一信号时更新同一事件，恢复后才关闭。这样历史页展示的是用户可理解的“一次持续异常”，而不是每 200/50 ms 一条报警。

**165. SQLite 为什么适合当前演示，什么时候不够？**  
答：单手机、单演示、局域网场景需要零配置和可导出，SQLite 足够且便于现场恢复。多用户并发、云端权限、跨设备同步和高写入吞吐时应迁移到服务端数据库，但不改变传感器协议和规则边界。

**166. 现有数据库如何增加温度日记录而不删除历史？**  
答：`Base.metadata.create_all` 创建缺失表，SQLite 启动时只对已存在表增加缺失列和索引；代码不会删除 `sensor_frames`、`risk_events` 或 `gait_episodes`。这属于当前竞赛数据库的轻量启动迁移，不是把历史重算成新医学结论。

**167. 标定重置会删除什么？**  
答：它删除当前活动基线、设置 reset 边界、结束活动风险并让未执行命令过期；历史事件、原始帧和已完成会话仍保留。换人或重新固定鞋垫时这样切会话，避免新旧个人基线混用。

**168. `/offline-sync` 为什么不补发马达？**  
答：离线帧可能已经过时，重新评估只能归档和重建历史/步态，参数 `allow_motor_command=false`。风险干预是面向当下负重的动作，过期动作不应在用户已经换姿势后突然震动。

**169. `/offline-interventions` 上传什么？**  
答：它上传 App 本地已记录的事件、DeviceCommand、每个设备 ACK 和 15 秒恢复结果；后端只做历史归档和幂等合并，不再次下发命令。这样断网仍能保留糖尿病足演示中的“提醒—执行—观察”证据链。

**170. Web Dashboard 和手机 App 的关系是什么？**  
答：Dashboard 是 FastAPI 提供的现场控制台，可显示热力图、组合风险、会话建议、导出和 CSV 回放；Flutter 是正式移动端。CSV 回放始终标注 `csv_replay`，不产生 BLE 马达命令，不能拿来冒充临床实测。

## H. 个人基线与压力风险算法（171–180）

**171. 为什么每次穿戴都要重新建立个人压力基线？**  
答：FSR 原始电阻受体重、足型、鞋垫贴合、分压电阻和安装位置影响，跨人或跨穿戴直接比较会把硬件差异误报成风险。基线保存本次左右载荷比、六点区域分布、MAD 和通道可信度，回答的是“相对这个人平时是否变化”。

**172. 40 对基线帧怎样采集？**  
答：算法从双足、六点完整、稳定站立、相对平衡的配对中按约 200 ms 间隔取样，至少 40 对，通常需要 8–12 秒；窗口上限 60 个候选样本。移动、单脚离地、单点按压或不稳定帧不进入基线。

**173. 为什么基线要求每脚至少 3 个有效活动通道？**  
答：单点残余或空载电阻可能有非零读数，不能代表人体承重。至少 3 个达到活动下限的通道能证明鞋垫有多点接触，同时又允许手工鞋垫存在低灵敏度，避免把“没有读数”当成正常。

**174. 基线为什么用中位数和 MAD？**  
答：中位数对一次踩踏尖峰和手按异常不敏感，MAD 描述本次穿戴的噪声尺度。进入阈值取工程门槛与约 `6×MAD` 的较大值，既不把噪声当异常，也不让一次脏基线无限放大阈值。

**175. 左右总载荷为什么用对数比？**  
答：`log((left_total+ε)/(right_total+ε))` 对左右方向对称，减去本次基线后可以抵消两块鞋垫的整体灵敏度差；代码再用 `tanh` 把极端值压到稳定的 0–1 指标。这个量是相对负荷工程指标，不是体重百分比或临床压力单位。

**176. 0.20、0.16 和 6×MAD 是不是糖尿病足临床阈值？**  
答：不是，是 `backend/app/config.py` 集中的竞赛工程参数：0.20 进入、0.16 退出，MAD 提供自适应噪声门槛并有最大阈值限制。医学依据只支持关注异常机械负荷和减负方向，不能把这些数值写成溃疡阈值。

**177. 为什么有进入阈值和退出阈值两个数？**  
答：这是滞回，风险超过 0.20 才进入、恢复到约 0.16 才退出，避免边界抖动导致反复播报。对糖尿病足风险人群，稳定的提醒频率比一秒内反复“有/无异常”更可执行。

**178. 压力风险的 5、10、20 秒分别表示什么？**  
答：连续约 5 秒进入关注，约 10 秒播报“需要减负”，约 20 秒仍未改善才进入等级 3 马达候选；等级是内部工程状态。它表示异常持续时间，不表示“20 秒就会形成溃疡”，因为溃疡风险还取决于皮肤、神经、血管和长期暴露。

**179. 运行时只有 4 个有效压力点还能判断吗？**  
答：每脚至少 4 个有效且被基线信任的点时可以估算总载荷；无效点不改写成零，区域分数会标记不可用或使用剩余可信点。前掌还要至少两个前掌点同时受力，避免单点残余触发。

**180. P1–P4、内侧和外侧风险如何计算？**  
答：前掌风险是 P1–P4 占单脚总载荷的比例，相对个人基线增加约 15 个百分点并由多数有效落脚支持；内侧是 P1+P4 占前掌比例，外侧当前主要用 P2 占前掌比例。六点布局只能提供区域趋势，内外侧当前保留工程观察，不包装成临床病变定位。

## I. 温度证据、日记录和现场演示（181–190）

**181. 当前代码的温度工程阈值为什么不是 2.2°C？**  
答：IWGDF 的约 2.2°C/连续两日是家庭皮温监测参考；当前代码 `config.py` 使用约 2.5°C 的工程进入阈值和 2.0°C 退出阈值，作为尚未临床等效验证的保守原型参数。答辩要同时说清“医学参考”和“代码工程值”，不能混为一谈。

**182. 温度风险需要几对有效温区？**  
答：至少两个左右对应的有效温区才允许触发温度风险；某个 T 点无效只排除该点，压力仍然独立工作。单点温差不作为双足温度结论，避免一个坏 NTC 代表整只脚。

**183. 温度为什么不要求承重才能观察？**  
答：温度观察针对左右同点皮温差，脱鞋或静止时也可能有价值；压力则必须有真实多点承重。代码把温度质量和负重门控分离，但历史记录仍保存 `load_state`、`motion_state`，让使用者知道温差发生在什么状态。

**184. 8/15/30 秒温度窗口能代表两天吗？**  
答：不能。8 秒是设备观察窗口、15 秒语音窗口、30 秒持续窗口，都是现场工程交互；真实两日证据必须是两个连续自然日同一区域的记录。页面和 AI 必须明确“演示流程”与“真实跨日证据”。

**185. 温度短暂掉线为什么允许 1.2 秒宽限？**  
答：NTC 约 5 Hz，1–2 个采样短缺可能来自 ADC/接触瞬断；`TEMPERATURE_DROPOUT_GRACE_MS=1200` 维持已建立事件，超过后按恢复处理。它只避免闪烁，不会把长期无效通道变成有效温差。

**186. 同日温度记录如何合并？**  
答：`TemperatureDailyRecord` 以日期、侧别、区域和来源建立唯一约束，同日同区保留最强记录并更新事件时间/差值。`device_observation` 与 `demo` 来源分开，防止手按演示污染真实两日证据。

**187. 温度日记录里为什么保存运动和承重状态？**  
答：活动、鞋内接触、环境和手按都可能影响 NTC；记录状态是为了让会话 AI 和现场人员区分“静止设备观察”“走动中变化”和“脱鞋演示”。它不是临床证据质量的替代品，但能减少过度解读。

**188. 两日温度演示的种子记录是什么？**  
答：点击“准备两日温度演示”时，后端建立 `TemperatureDemoState`，带一个前一日 seed_date；随后现场手按生成当前日期记录，页面显示 demo `2/2`。两条记录始终带 demo_session_id 和演示来源，不参与真实评级累计。

**189. 为什么温度事件永远不发马达？**  
答：短时温升可能由手按、环境、接触或局部热惯性造成，且当前 NTC 未做临床等效验证；机械震动不是温度指南规定的处置。温度只触发观察/语音，压力持续等级 3 才走现有减负提醒闭环。

**190. 温度基线校正会不会把真正的热点抵消掉？**  
答：基线校正只移除稳定装配偏差，并要求当前原始温差仍有可见支持（代码有 raw support 下限）；两脚当前几乎同温时不会凭校正凭空报警。大原始温差也会保留，避免把真实变化隐藏在补偿里。

## J. 行走、提醒、AI 与临床转化（191–200）

**191. 运动状态如何由 IMU 得出？**  
答：代码计算加速度模长与 1g 的差、陀螺模长及相邻向量变化；静止约束是加速度偏差不超过 3 m/s²、陀螺不超过 12°/s，移动还需要明显变化。它是状态门控，不是临床步态分类器。

**192. 为什么要连续 3 个移动帧才显示行走？**  
答：在 5 Hz 样例/后端配对节奏下约相当于 600 ms 的运动证据，可过滤马达瞬态和单个 IMU 抖动；代码常量是 `GAIT_MIN_ACTIVE_MOTION_FRAMES=3`。固件 SensorData 当前目标频率是 20 Hz，若实际帧率变化，后端仍应以时间戳和配对窗口判断，不能把帧数直接当秒数。

**193. 12 秒步态窗口为什么这样选？**  
答：它足以容纳短距离演示的多次左右交替，同时限制历史计算量和延迟。窗口、4 秒最短观察、最近 1.5 秒有新落脚都是工程参数，不是糖尿病足临床步态标准。

**194. 一次落脚候选需要哪些压力条件？**  
答：候选来自左右载荷转移，要求相邻候选至少间隔 250 ms，并结合可信压力通道和运动状态；单脚残余或没有双足基线不能算有效步。这样避免手按一个 FSR、马达振动或 BLE 重复帧虚增步数。

**195. 风险等级 0–3 和步态段怎样关联？**  
答：压力/温度静态规则内部使用 0–3 级，约 5/10/20 秒压力持续分别对应关注、播报、持续未改善；行走段只产生工程观察和语音，不触发马达。有效段至少 6 步、左右各 3 步，连续三段同向同类型且累计至少 18 步才形成重复趋势；这些都不是 IWGDF 临床分级。

**196. 马达为什么只震风险侧，如何避免它改写真实状态？**  
答：等级 3 时命令包含规则确定的 target，自动使用 `long` 1500 ms；云端 AI 不能决定侧别。后端只在目标脚的执行和 settle window 内屏蔽马达诱发的 MPU 运动，压力仍按实时多点受力判断，因此震动不能把持续偏载强行显示为正常。

**197. 干预后的改善怎样落到糖尿病足需求？**  
答：提醒用户减轻异常机械负荷后，系统比较执行前约 3 秒与 15 秒窗口末端约 5 秒的静止压力异常量，每侧至少 5 对有效帧；下降 50%/20% 分别标记有效/部分改善，负值标记加重。它只能说明短时受力变化，不能说创面愈合或替代医生减负处方。

**198. 大模型在这条链路中具体做什么？**  
答：`risk_service` 先确定风险和马达，`session_service`/`analytics` 生成事件、步态、温度、质量、足部背景和血糖摘要，`ai_advisor_service` 再把摘要组织成观众能理解的结论、当前动作、下一步观察和专业评估条件。云端超时、Key 缺失或格式不合格时回退本地模板，不阻断规则闭环。

**199. 风险评级、健康背景和血糖为什么不能合成一个“糖尿病足分数”？**  
答：评级只描述本设备近期压力、步态和真实温度证据；健康档案是既往溃疡/截肢和感觉/供血提示，血糖是用户自测背景，三者不能替代神经、血管、皮肤检查。App 因此显示依据和质量，而不伪造 IWGDF 0–3 级或溃疡概率。

**200. 现在的工程证据怎样转化为临床证据？**  
答：仓库测试可证明协议解析、质量门控、风险边界、离线幂等和 UI 状态按设计工作；CSV 和健康体验者只能证明联调与方向。下一步要固定点位并用糖尿病风险人群、临床压力垫、校准温度仪、医生检查和预注册终点评估重复性、敏感度、特异度和不良事件，在此之前只能称为辅助监测原型。

## 参考资料和代码索引

- IWGDF 2023 Prevention Guideline：<https://iwgdfguidelines.org/wp-content/uploads/2023/07/IWGDF-2023-02-Prevention-Guideline.pdf>
- IWGDF 2023 Offloading Guideline：<https://iwgdfguidelines.org/wp-content/uploads/2023/07/IWGDF-2023-06-Offloading-Guideline.pdf>
- ADA Standards of Care 2026，Foot Care：<https://diabetesjournals.org/care/article/49/Supplement_1/S261/163919/12-Retinopathy-Neuropathy-and-Foot-Care-Standards>
- ADA Standards of Care 2026，Glycemic Goals：<https://diabetesjournals.org/care/article/49/Supplement_1/S132/163927/6-Glycemic-Goals-Hypoglycemia-and-Hyperglycemic>
- 协议和字段：`protocol/ble_protocol_v1.md`、`protocol/api_contract_v1.md`、`protocol/field_dictionary.md`
- 风险规则：`backend/RISK_RULES.md`、`backend/app/config.py`、`backend/app/services/risk_service.py`
- 评估与会话：`backend/app/services/assessment_service.py`、`backend/app/services/session_metrics.py`
- 固件采集和协议：`firmware/main/footguard_real_sensor.c`、`footguard_fsr.c`、`footguard_ntc.c`、`footguard_mpu6050.c`、`footguard_protocol.c`
- Flutter BLE 和离线：`mobile_app/lib/services/ble_frame_parser.dart`、`frame_pairing_service.dart`、`monitoring_controller.dart`、`local_risk_engine.dart`
- 工程样例和验证：`sample_data/`、`tools/generate_mock_data.py`、`tools/validate_protocol.py`、`backend/tests/`、`mobile_app/test/`
