myt-bot/footguard/protocol/examples/ble_test_vectors_v1.md

# FootGuard BLE v1 标准测试向量

所有多字节整数均为 little-endian。SensorData CRC 使用 CRC-16/CCITT-FALSE，计算偏移 0～57，CRC 值按小端序写入偏移 58～59。

## 左脚帧

对应 JSON：left_frame.json。

| 项目 | 值 |
|---|---|
| 总长度 | 60 字节 |
| side 编码 | 0 |
| sync_id | 1 |
| packet_seq | 1 |
| timestamp_ms | 1760000000000 |
| acceleration mg | [2, -3, 997] |
| CRC 数值 | 0x1C2F |
| CRC 帧内字节 | 2F 1C |

完整帧见 sensor_frame_left_v1.hex。

## 右脚帧

对应 JSON：right_frame.json。

| 项目 | 值 |
|---|---|
| 总长度 | 60 字节 |
| side 编码 | 1 |
| sync_id | 1 |
| packet_seq | 1 |
| timestamp_ms | 1760000000020 |
| acceleration mg | [-1, 2, 998] |
| CRC 数值 | 0x25C3 |
| CRC 帧内字节 | C3 25 |

完整帧见 sensor_frame_right_v1.hex。

## TimeSync

| 项目 | 值 |
|---|---|
| 总长度 | 12 字节 |
| sync_id | 1 |
| unix_time_ms | 1760000000000 |

完整字节见 time_sync_v1.hex。

## 自动测试要求

1. 固件编码器对同一字段输入必须生成与 `.hex` 文件完全一致的 60 字节。
2. Flutter 解析器必须把 `.hex` 文件还原为对应 JSON 中的字段；IMU 浮点值允许由量化导致的微小误差。
3. 修改任意受 CRC 保护的字节后，CRC 校验必须失败。
4. 交换 CRC 两个字节后，CRC 校验必须失败。
