myt-bot/footguard/backend/RISK_RULES.md

# FootGuard 基础风险、个人基线与马达规则

这些参数仅用于物联网竞赛原型验证，不是医疗诊断或治疗标准。

## 输入有效性

- 左右有效帧需具有相同 `sync_id`、相同 `packet_seq`，时间差在允许窗口内。
- 时间未同步、传感器卡死、双足身份/同步编号不匹配或单侧长期缺失时输出 `data_incomplete`。
- 温度质量只约束温度判据：单点无效只排除该点，少于两个有效左右同区温度对时暂停温度风险；压力显示和压力闭环继续。
- 压力质量只约束压力判据：无效点不得当成零压力。运行期每脚至少 4 个有效压力点时可按个人基线估算总载荷；有效点不足时暂停压力风险。压力风险还要求至少一只脚有 2 个可信通道同时达到受力下限，单个 FSR 的空载残余或单点手压不作为穿戴承重。前掌判据要求至少 2 个前掌点同时受力，并保留至少 1 个有效后部点作为基线参照；真实前倾时不要求后跟继续承重。标定未覆盖的区域通道只有在后续出现稳定、多点真实承重时才重新参与分析；空载残余和单点按压仍会被排除。
- 当前布局固定为每脚 `pressure[6] + temperature[4]`，布局标识为 `layout_6p4t_v1`。
- App 和后端会短时保留最近一次完整配对，避免左右 BLE 的轻微到达偏差造成页面闪烁；不会用旧数据长期伪装在线。

## 个人基线

- 系统从双足稳定承重、负重相对平衡且六个压力点完整的配对帧中学习本次穿戴基线；每脚总量至少为 `0.04`，并要求至少 3 个通道达到 `0.005`。这个较低总量门槛仅用于适配低灵敏度手工鞋垫，运行期风险仍使用独立的承重门槛；温度和 MPU 缺失不阻止压力基线（MPU 明确检测到移动时会暂停采样）。
- 当前至少需要 40 对合格帧，通常约 8～12 秒；中位数和 MAD 用于抵抗偶发噪声并形成个人自适应阈值。
- 实时页和设置页显示“学习中 x/40”、失败原因和重新穿戴入口；达到 40 对后仍需通过承重稳定性校验，界面会提示继续自然站立，不把 40/40 误写成已锁定。
- 重新标定直接删除当前活动基线但不删除历史事件；正在进行的风险会中断，未执行命令会过期。
- 计算后的基线保存到 `calibration_profiles`，包含左右设备、布局、创建时间、样本数、载荷比、区域分布、噪声尺度和通道可信度。后端重启或超过 2000 帧后仍可使用；设备或布局变化会立即要求重标定。
- 基线完成前压力热力图继续显示，压力异常描边、压力风险和压力马达保持关闭；温度风险仍按自身有效数据独立工作。
- 更换体验者、移动传感器、改动分压电阻或重新固定鞋垫后必须重新校准。

## 与体重无关的压力判定

系统不使用“某压力原始值大于固定值”直接报警。

1. 双足偏载使用约 1 秒滚动中位数后的 `log((left_total + ε) / (right_total + ε))`，再减去本次穿戴基线中位数，消除手工左右鞋垫的整体灵敏度差。
2. 进入阈值取工程最小变化和 `6 × MAD` 噪声门槛的较大值；退出阈值更低，避免临界反复。
3. 前掌风险使用 P1～P4 占单脚总载荷比例相对个人基线的增量，同样采用工程阈值与 MAD 自适应门槛。
4. 内侧局部集中使用 P1+P4 占前掌载荷比例，外侧局部集中使用 P2 占前掌载荷比例，均与本次穿戴的个人基线比较。
5. 所有站立风险独立判断。双脚前掌同时成立时合并为“双脚前掌负荷持续集中”；兼容接口所需的主风险只按等级和首次触发时间选择，不隐藏其他风险。
6. 单点运行期无效时，使用其余有效点和基线分布估算足总载荷；该点区域分数置零并在 App 中置灰。
7. 热力图基础颜色只表达当前低到高受力，不代表异常；个人基线完成后，有效区域分数可直接驱动异常描边，不要求先命中某个组合风险。

当前工程默认值集中在 `backend/app/config.py`。固定前采集的数据可用于证明通道响应和风险方向，但不作为最终标定真值；传感器固定并稳定后只复核这些参数，不改变整个闭环架构。

## 温度判定

- T1 前掌外侧、T2 拇趾/第一跖骨头邻近、T3 足跟中央、T4 中足中央。
- 左右脚按解剖方向镜像，同一通道代表同一解剖区域。
- 比较左右同区温差，并扣除个人正常温差基线。
- 至少两个有效左右同区温度对才允许触发温度风险；单点或全部温度缺失都不会影响压力功能。
- 校正后的同区温差绝对值达到默认 2.0℃时进入 `temperature_asymmetry` 候选窗口，风险侧为温度更高的一侧。
- 温度只用于趋势辅助提醒；演示时用手掌缓慢捂热，不使用可能烫伤皮肤或损坏传感器的热源。

## 持续时间与分级震动

- 对数载荷比相对基线变化达到工程门槛或基线噪声门槛时进入偏载候选窗口。
- 压力连续约 5 秒为 attention（等级 1），约 10 秒为 warning（等级 2），约 20 秒为 persistent（等级 3）；温度使用更保守的 8/15/30 秒窗口。
- 等级 0/1/2：不产生马达命令；等级 2 只进行一次准确风险名称播报。
- 等级 3：只向达到最高等级的风险侧发送一次 `long` 震动命令，时长 1500 ms。
- 语音去重按每个风险独立计时：同轮多个新风险一句播报，持续期新增风险立即播报；某风险自身连续消失满 5 秒后才重新获得播报资格。
- 同一连续事件只创建一条马达命令；后端、App 与固件的去重共同避免轮询或 ACK 重试导致重复震动。
- 每个命令具有 `command_id`、有效期和目标侧；App 与固件均执行去重和过期校验。
- 云端大模型只解释确定性结果，不得自由决定目标侧、等级或震动模式。

## 基础步态观察

- 使用本次站立基线的左右负载比校正鞋垫灵敏度，再结合左右承重交替和 MPU 运动状态识别静止或行走。
- 实时结果统计近 12 秒落脚候选、左右候选数和基于相邻候选间隔的估算步频；行走至少需 4 秒、6 次交替落脚，且最近 1.5 秒有新落脚。
- 连续静止约 2 秒后，以完整运动段生成确定性记录；时间重叠的重复结果更新同一条记录。每段至少 6 次有效落脚、左右各至少 3 次，且每足至少有 4 个原始有效并受个人基线信任的压力通道。
- 每段记录步数、步频、左右落脚、步时变异、左右压力时间积分和前掌/内侧/外侧负荷比例。单段达到主问题阈值即可触发一次语音工程提醒。
- 单侧负荷偏高阈值为相对不对称 30%；前掌反复受压要求高于个人基线 15 个百分点，且至少 70% 的有效落脚支持。同一穿戴会话最近连续 3 段均出现同一类型和方向、累计至少 18 次落脚时，另外记录为重复趋势，供历史与会话 AI 综合分析。
- 内侧、外侧和步时波动保留为工程指标，暂不进入正式趋势。低步频只展示，不单独判异常；行走趋势不触发马达。
- 行走期间暂停现有静态压力风险的语音和马达，避免正常迈步被当成持续偏载；温度趋势仍独立工作。
- 该功能是工程观察，不输出拖步、病理步态或糖尿病足诊断。完整分型需在降低丢帧后采集多人、重复路线和人工标注数据。

## ACK 与干预效果

- ESP32 执行后通过 AckEvent 返回 `executed/rejected/expired/failed`。
- App 把真实设备 ACK 上传后端；相同设备的相同 ACK 幂等保存。
- 事件结束时优先关联已执行命令。干预前取约 3 秒有效静止配对帧中位数，干预后取 15 秒观察窗末端约 5 秒中位数，每侧至少 5 个有效配对帧。
- 左右负载、前掌、内侧和外侧压力事件均按相对个人基线的异常量计算改善率，并区分 `effective/partial/ineffective/worsened`；数据不足时不计算。温度始终为观察项，不使用短时压力改善率。
- 历史页展示指标名称、干预前后异常量、改善或加重比例与数据充分性，不展示设备 ACK 文字或统计；后端仍保留 ACK 用于确认真实执行和确定改善观察起点。

## 固定完成后的数据复核清单

1. 确认空载六路压力接近零且不会跨通道跳变。
2. 逐点按压验证 P1～P6 的实物映射。
3. 自然站立三次，确认基线可重复建立。
4. 验证偏左、偏右、前掌持续高载和恢复四个场景。
5. 比较两脚同区温度；先排除接触不良，再考虑改阈值。
6. 所有阈值修改都保留原始记录、修改理由和复测结果。
