myt-bot/footguard/firmware/main/footguard_ntc.h

#ifndef FOOTGUARD_NTC_H
#define FOOTGUARD_NTC_H

#include <stddef.h>

#include "esp_err.h"

enum {
    FOOTGUARD_NTC_CHANNEL_COUNT = 4
};

typedef struct {
    int raw_average;
    int voltage_mv;
    float temperature_c;
} footguard_ntc_reading_t;

esp_err_t footguard_ntc_init(void);

esp_err_t footguard_ntc_read_channel(
    size_t channel_index,
    footguard_ntc_reading_t *reading);

esp_err_t footguard_ntc_read(footguard_ntc_reading_t *reading);

#endif
