myt-bot/footguard/(commit log)

2026-07-19 feat: add reproducible dual-foot mock datasets
    [intervention_recovery.csv, left_forefoot_high.csv, left_load_bias.csv, normal_stand.csv, normal_walk.csv, right_disconnect.csv, right_load_bias.csv]
2026-07-19 feat: implement dual-foot risk and motor command loop
2026-07-19 feat(firmware): initialize ESP-IDF protocol encoder
2026-07-19 fix: align temperature sensor positions
2026-07-19 feat: update sensor layout, risk analysis, and mobile app
    [intervention_recovery.csv, left_forefoot_high.csv, left_load_bias.csv, left_temperature_rise.csv, normal_stand.csv, normal_walk.csv, right_disconnect.csv, right_load_bias.csv]
2026-07-19 修复：冻结6P4T传感器映射并完善质量标志校验
2026-07-19 feat: 将固件升级为6P4T六十字节协议
2026-07-20 功能：实现BLE服务与6P4T模拟数据流
2026-07-20 修复：完善NimBLE通知特征注册并匹配8MB闪存
2026-07-20 feat: add 60-byte BLE sensor frame parser
2026-07-20 feat: add BLE scan device classification
2026-07-20 feat: add BLE scanning controls to device screen
2026-07-20 feat: connect dual-foot BLE devices from device screen
2026-07-20 文档：补充左脚BLE实机验证报告
2026-07-20 feat: synchronize device time after BLE connection
2026-07-21 fix: stabilize BLE scan and synchronize device time
2026-07-21 feat: receive and parse BLE sensor notifications
2026-07-21 feat: stream BLE sensor frames to realtime monitoring
2026-07-21 feat: 添加单路FSR和NTC传感器验证
2026-07-21 feat: automatically reconnect known BLE foot devices
2026-07-21 feat: 添加MPU6050单模块验证
2026-07-21 feat: bridge backend motor commands to BLE device ACKs
2026-07-21 feat: 添加GPIO13马达控制验证
2026-07-21 docs: 更新固件传感器与马达验证进度
2026-07-21 refactor: 取消马达开机自动震动
2026-07-21 feat: 添加DeviceCommand解析与自测
2026-07-21 feat: 在GATT入口解析DeviceCommand
2026-07-21 feat: 添加AckEvent BLE通知通道
2026-07-21 feat: 添加马达震动模式执行函数
2026-07-21 feat: 添加异步马达命令执行队列
2026-07-21 feat: 校验并异步执行DeviceCommand
2026-07-21 feat: 防止马达命令重复执行
2026-07-22 fix: 防止马达执行状态被双足状态覆盖
2026-07-22 docs: 更新马达命令与ACK闭环进度
2026-07-22 feat: 添加真实传感器统一数据源
2026-07-22 feat: 切换BLE到真实传感器数据源
2026-07-22 feat: 添加真实传感器帧诊断日志
2026-07-22 feat: 扩展四路NTC ADC驱动
2026-07-22 feat: 将四路NTC接入真实传感器帧
2026-07-22 refactor: 共享FSR与NTC的ADC1单元
2026-07-22 feat: 扩展六路FSR ADC驱动
2026-07-22 feat: 添加FSR P1原始值诊断
2026-07-22 feat: 添加六路FSR原始值诊断
2026-07-22 feat: 将六路FSR接入真实传感器帧
2026-07-22 fix: 抑制FSR空载噪声导致的热力图跳动
2026-07-22 build: 支持独立构建左右脚固件
2026-07-22 chore: 忽略左右脚固件构建目录
2026-07-22 fix: 在BLE操作前配置设备队列模式
2026-07-22 fix: 同步双足BLE传感器帧
2026-07-23 fix: 屏蔽无效传感器数据与异常展示
2026-07-24 feat: 添加大模型风险解释Mock接口
2026-07-24 feat: 接入可降级的云端大模型服务
2026-07-25 fix: 稳定双足实时帧配对
2026-07-25 feat: 在实时页展示云端大模型建议
2026-07-26 feat: 配置个人基线校准阈值
2026-07-26 feat: 按真实双足承重学习个人基线
2026-07-26 test: 覆盖真实承重个人基线校准
2026-07-26 fix: 锁定首次稳定承重基线
2026-07-26 test: 验证校准前热力图保持中性
2026-07-26 test: 先校准个人基线再验证风险闭环
2026-07-26 test: 隔离校准前前掌高载场景
2026-07-26 fix: 基线完成前禁止马达提醒
2026-07-26 feat: 完善应用设置功能
2026-07-26 feat: 完善风险干预闭环与个人基线管理
2026-07-27 feat: 添加固定问题大模型问答
2026-07-27 fix: 完善实时监测与历史干预评估闭环
2026-07-27 feat: 使用MPU识别活动状态并约束基线学习
2026-07-27 fix: 稳定压力风险识别与区域热力图
2026-07-27 fix: 稳定风险连续性与实时显示
2026-07-27 fix: 允许空载触发温差预警
2026-07-27 test: 覆盖空载温差预警
2026-07-27 test: 对齐温差风险优先级
2026-07-27 fix: 统一温差显示与告警阈值
2026-07-27 fix: 原始温差过高时优先触发告警
2026-07-27 test: 覆盖基线不能掩盖七度温差
2026-07-27 fix: 放宽空载温差演示阈值
2026-07-27 test: 覆盖二点九七度右脚温差告警
2026-07-27 fix: 稳定空载温差风险连续性
2026-07-27 test: 覆盖实机温差侧别与连续性
2026-07-27 fix: 容忍温度传感器短暂掉点
2026-07-27 fix: 稳定持续温差风险判定
2026-07-27 test: 覆盖温差短暂掉点与恢复
2026-07-27 fix: 保持温差掉点期间风险侧别稳定
2026-07-27 test: 使用真实基线验证温差掉点容忍
2026-07-27 fix: clear recovered temperature risk after dropout grace
2026-08-13 Improve multi-risk pressure analysis and channel diagnostics
2026-08-13 改进压力连续性与穿戴状态诊断
2026-08-13 优化偏载恢复前倾识别与温差阈值
2026-08-13 修复前掌未覆盖通道导致的漏报
2026-08-14 增加离线闭环与现场Web演示
2026-08-14 feat: 完成温度偏置补偿与风险时长修复
2026-08-14 feat: 完成App稳定演示风险闭环与会话分析
2026-08-14 docs: 添加App交接与双人标注数据
    [person_a_session_01.csv, person_b_session_01.csv]
2026-08-14 feat: 将鞋垫传感器采样提升至20Hz
2026-08-14 feat: 完善 App 语音、风险闭环与历史
2026-08-14 fix: 为20Hz标定增加时间门控
2026-08-14 feat: 完善实时监测与穿戴基线
2026-08-14 feat: 增强站立风险与步态评估
2026-08-15 feat: 降低步态误报并增强会话分析
2026-08-21 fix: 修复步态识别并完善会话展示
